fhyy/MF2063-ESS-NW-CAR/pcb/README.md

# PCB and schematics for the powering and communication 
In the "Power schematics" is the simulation file for the boost converter. The simulation program is MPLAB from Microchip and is used because the an IC from Microchip. In the folder pcb is the Eagle files for the power unit and the Arduino boards.
