fhyy/MF2063-ESS-NW-CAR/platform/README.md

## 3D models for Platform 
The platform for the car was simulated in Autodesk Fusion 360 and the schematics was exported to print out  the pieces on the laser cutter and 3D printer.
