fhyy/MF2063-ESS-NW-CAR/pcb/Power-Schematics/README.md

# Power schematics
In this folder is the file boost_converter_ess and is a MPLAB file to simulate the boost converter simulation.
