fhyy/MF2063-ESS-NW-CAR/pcb/pcb/README.md

# PCBs

# Board for Arduino IR esc
This is the file for the Arduino board to connect the the Speed sensor and ESC to steer them from Arduino 

# Board for Arduino ultras servo 
This is the file for the Arduino board to connect Ultrasound and steering servo.

# Ess car 
Is the file for the power unit and includes the boost converter 

# Ess car with out DC-DC
This the design for the power unit with out the boost converter.
