fhyy/MF2063-ESS-NW-CAR/ess-car-assignments/wishlist1/ESS-CAR-Design review wish_1.docx

# Design review wish-list #1

This is the first time you will meet the expert panel. At this stage you should have understood the task at hand. You should also have a project plan and stated the specific requirements for your task. This runs in parallel with the project management course EH2760.

Prepare a short presentation (~5 min) of your project. To get as good feedback as possible from the expert panel, prepare the wish-list below. Make sure that you think this through so you get as much as possible from this session. Focus on the “big issues”.

Make sure that you upload this to Canvas before the deadline (see kick off presentation).

## <Project title>

(Add information if the project task diverges from the initial project description)

KTH ESS-Car Embedded Services for a Self-Adaptive Car

## Wish-list

(State what you would like to discuss below. It can be high and low. Everything from real time control problems to manufacturing questions).

1. We plan to use a ultrasonic sensor to detect entities that in front of the car and a camera based on raspberry pi to capture visions. We want to discuss the combination of these sensors.
2. We have defined some errors that can be injected to the car and their related detection methods. We want to discuss if this is in the right path.
3. After some background study about anomaly detection, I think maybe some techniques corresponding to intelligent data processing can be introduced to detect fault. We wonder what sensitive fault features are in this prototype and what kind of data can be used in data processing and analysis.
4. The online datasets about labeled shapes are hard to find. We only found two datasets with low pixel numbers, which will have low performance on practical test. We’d like to know that whether there is a labeled shape dataset with higher pixel numbers.

MF2063 Embedded systems design project
