fhyy/MF2063-ESS-NW-CAR/Project_Management/Final_Report_Management/ESS-CARNW_2018_finalreport_1.pdf

KTH Management of Projects

EH2760, HT 2018

FINAL REPORT

# ESS-NW/ESS-CAR

Jonas Ekman

Yini Gao

Jacob Kimblad

Leon Fernandez

Fredrik Hyyrynen

Yifan Ruan

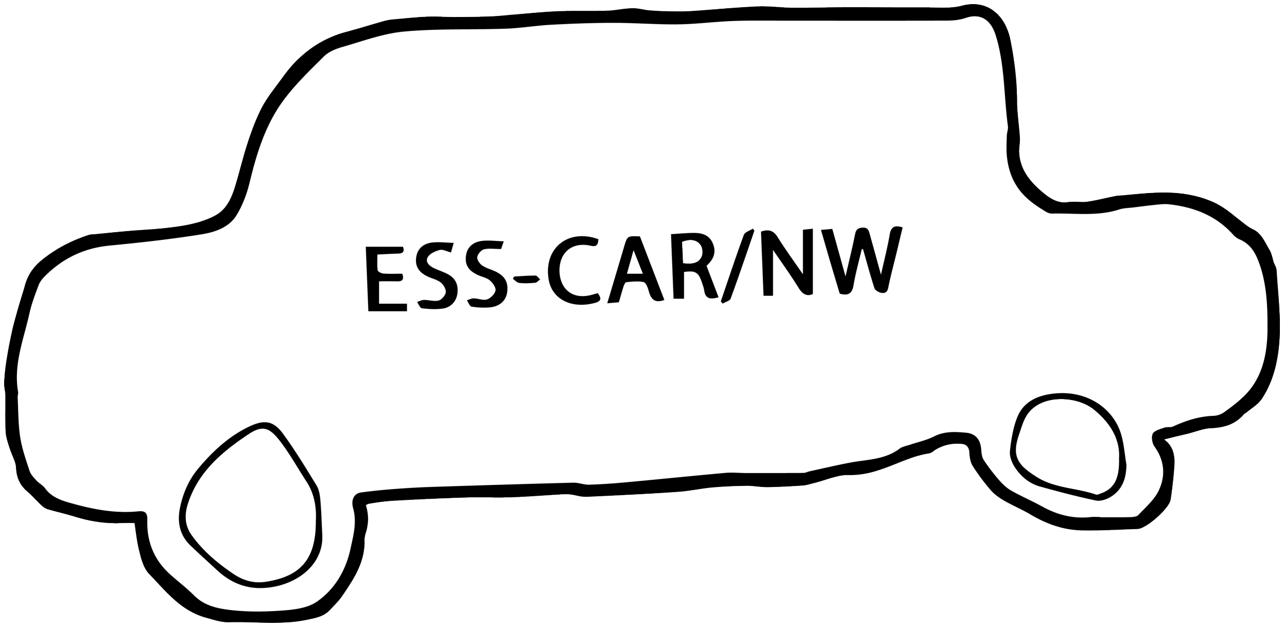
[picture p43: figure]

December 14, 2018

EH2760 Management of Projects ESS-NW/ESS-CAR
Leon Fernandez, leonfe@kth.se

Final Report
Version 1
1(8)

## 1 General Summary

A prototype for an autonomous car has been built. As requested, the car is able to do some basic self-monitoring and uses ethernet with a network controller for on-board communication. Unfortunately, it is not able to consistently track a flag, which was another requirement.
Due to integration issues, a lot more time than planned had to be spent during the last weeks of the project. The budget was exceeded by roughly 74%.
The integration issues consisted mostly of problems with the interprocess communication between different software tasks. During integration, it was also found that ordering PCBs via KTH was not possible and that the PCB machines available to the group were broken. The interprocess communication and the PCB issues were the main causes of delay in the project.

## 2 Follow-up of objectives

2.1 Goals

1. The computer vision system of the car does not have the required performance to properly follow a green circle held in front of the car.
2. The hardware has been extended to include one unique processor for each sensor or actuator node and the car has all the functionality it needs to keep a distance of 30 cm to an object in front.
3. The car has been made failsafe to the extent that it can detect if any of the major nodes are missing. Most importantly, the node that controls the motor can by itself stop the car within the required time, even if it gets isolated from the other nodes. No battery level reading has been implemented.
4. The software running on the controller node checks the availability of all subsystem and does not start if any of them are missing.
5. The physical layer has been set in a topology that allows the SDN-system to route packets to and from all nodes.
6. The SDN system consists of a SDN-controller that runs on a Raspberry Pi and Zodiac FX OpenFlow switches.
7. There is only one route between any two given nodes that are connected as hosts to the SDN system. As long as the SDN system is activated, packets are always take this route.
8. The SDN controller does not reassign network resources during runtime.

2.2 Action Plan

Goals 1, 3 and 8 cannot be considered completed. No action will be taken for goal 3 since the current situation was deemed acceptable by the stakeholders. The cause of failure for goal 1 and 8 have been identified and the shareholders have been notified. The action taken for these failures is to hand over a well-documented repository to the stakeholders so that they can have another group of students solve these issues in a future course round.

EH2760 Management of Projects ESS-NW/ESS-CAR
Leon Fernandez, leonfe@kth.se

Final Report
Version 1
2(8)

## 3 Lessons learned and suggestions for improvement

The experience with the project has, in general, been good. Most members felt that they got to work with relevant topics and try out new ideas. Furthermore, all members got to try out professional engineering tools and methods that will be useful in the future. Some examples include cmake, Doxygen, Slack, Fusion 360, Eagle and PyChar.
However, the group had quite a few experiences with inefficient meetings and throughout most of the project there was a consensus that more people were required. Although, an effort was made to implement a Scrum system using the Trello platform as well as a physical whiteboard, it did not work out in the end. Also, the integration of all the software subsystems got delayed, partly due to difficulties with both making and ordering a PCB.
Despite the difficulties with ordering a PCB and the inefficient meetings, most of the communication with suppliers and stakeholders worked smoothly. Lastly, even though not all goals were fulfilled, the project members felt that they made the right choices in prioritizing what would be the final deliverables.

3.1 Lessons learned

- To improve the time utilization, it would have been good to have a project manager who does little or no development.
- To improve the Scrum system, only one board should have been employed instead of using both a whiteboard and a digital Scrum board.
- To improve the meeting efficiency, a more formal meeting structure should have been employed.
- More flexibility when it comes to restating the goals. For instance, the goals should have been restated when it at one point was discovered that previous work would have to be redone.
- Write more detailed technical requirements that can help facilitate the task breakdown.

## 4 Summary of time and resource plans

The final versions of the time and resource plans can be seen in Figure 3 and 2. All tasks up until mid-november were dealt with in time. After that, a lot of tasks hade to be postponed and the order of some of the tasks had to be changed as well. This was mostly due to integration problems with the different software subsystems that had been developed. Something that was missing in the time plan that could have mitigated this issue was to set aside a few days for implementing the interprocess communication between software tasks, as this was the main reason for the integration problems. Another reason for the delay was issues with ordering PCBs and broken PCB prototype machines. Unfortunately there was nothing in the risk analysis that reflected this specific issue, which could probably have been mitigated with some simple proactive measures like hand soldering prototype cards early on in the project.
Note: Milestones that were never met are denoted by a red semicircle in Figure 2.

## 5 Final comments

We in the group felt that we really made an effort to conduct the project in a professional and structured way. However, we also felt that with a project manager who also was a developer, this was very difficult. The project would really have benefitted from having one person with an overview of the status of all subsystems, so that resources can be delegated accordingly. Despite the shortcomings

EH2760 Management of Projects ESS-NW/ESS-CAR
Leon Fernandez, leonfe@kth.se

Final Report
Version 1
3(8)

of the project, we still feel that we have gained some valuable knowledge and experience, both in pure technical skills and within project management.

EH2760 Management of Projects ESS-NW/ESS-CAR
Leon Fernandez, leonfe@kth.se

Final Report
Version 1
4(8)

## A EVM

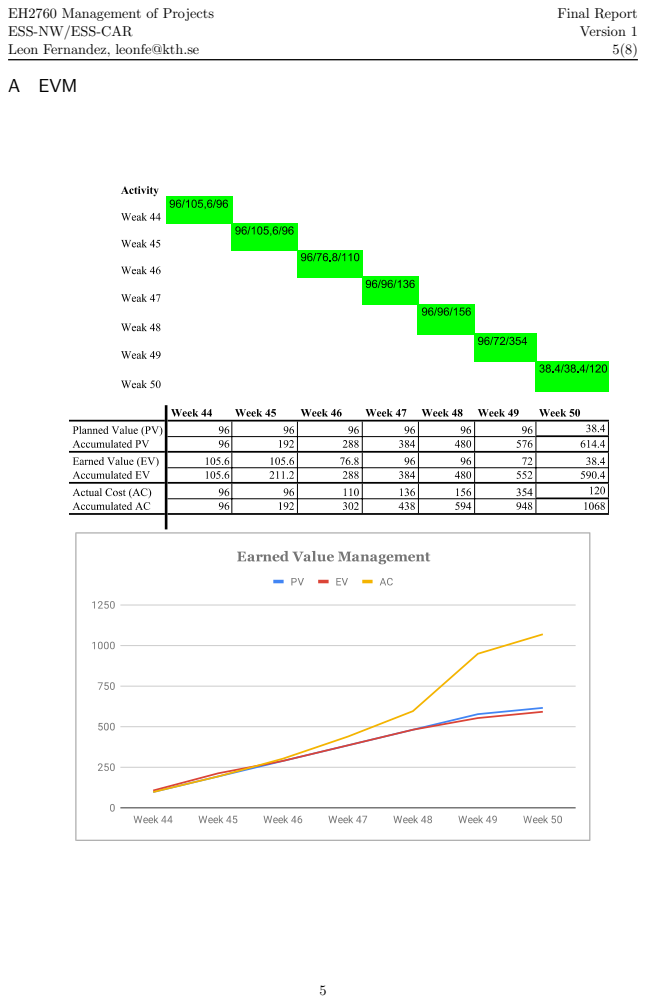
[picture p44: page 6]
Final Report Version 1 5(8)

EH2760 Management of Projects
ESS-NW/ESS-CAR
Leon Fernandez, leonfe@kth.se

Figure 1: Earned Value Management analysis.

EH2760 Management of Projects ESS-NW/ESS-CAR
Leon Fernandez, leonfe@kth.se

Final Report
Version 1
6(8)

## B Time Plan

## C Resource Plan

EH2760 Management of Projects ESS-NW/ESS-CAR
Leon Fernandez, leonfe@kth.se

Final Report
Version 1
7(8)

Project name: ESS-CAR/NW Milestone chart

Group number:

Oct Nov Dec

Day 29 30 31 1 2 3 4 5 6 8 9 10 11 12 13 14 15 16 17 18 19 20 21 22 23 24 25 26 27 28 29 30 1 2 3 4 5 6 7 8 9 10 11 12 13 14 15 16

Milestone/ tollgate O/ 30,5 15,16 29 17,18 3 13,25 19,21 27 1,7,9,11 31 2,4,6,8,10,12,14,26,28 20,22 23 24 32

Updated:

10/10/2018

11/9/2018 ● ● ● ▼ ● ●▼ ◯ ◯ ◯ ◯ ▽ ◯ ◯ ◯ ◯◯ ◯ ▽ ▽ ▽ ▽ ▽ ▽ ▽ ▽ ▽ ◯ ▽ ◯ ▽ ▽

11/15/2018 ● ◯ ◯ ● ▼ ● ◯ ● ● ◯ ◯ ▽ ▽ ▽ ▽ ▽ ▽ ▽ ▽ ▽ ◯ ▽ ◯ ▽ ▽

11/29/2018 ◯▽ ▽ ▽ ▽ ▽ ▽ ▽ ▽ ▽ ▽ ◯◯ ◯ ◯◯ ◯ ▽ ▽
12/13/2018 ● ▼ ▼ ▼ ▼ ▼ ▼ ▼ ▼ ▼ ▼ ● ◓ ● ● ● ●▼ ▼

Project manager Milestone O / Tollgate

1 SDN Network done 5 Vision object detection done 9 Boot up sequence done 13 Power supply for car done 17 Status report 2 done 21 Status report 3 submission

2 SDN Network approved 6 Vision object detection approved 10 Boot up sequence approved 14 Power supply approved 18 Status report 2 submission 22 Status report 4 submission

3 Control software for car done 7 Collision detection done 11 Fault handling done 15 Status report 1 done 19 Status report 3 done 23 Final report done

4 Control software of car approved 8 Collision detection approved 12 Fault handling approved 16 Status report 1 submission 20 Status report 4 done 24 Final report submission (Embedded Design Project)

25 Assemble car done 27 Autonomous system done 29 Working SDN prototype 31 Working autonomous prototype

26 Assemble car approved 28 Autonomous system approved 30 Working sensor and actuators prototype 32 Final report submission (Embedded Design Project) Figure 2: Time plan for the project.

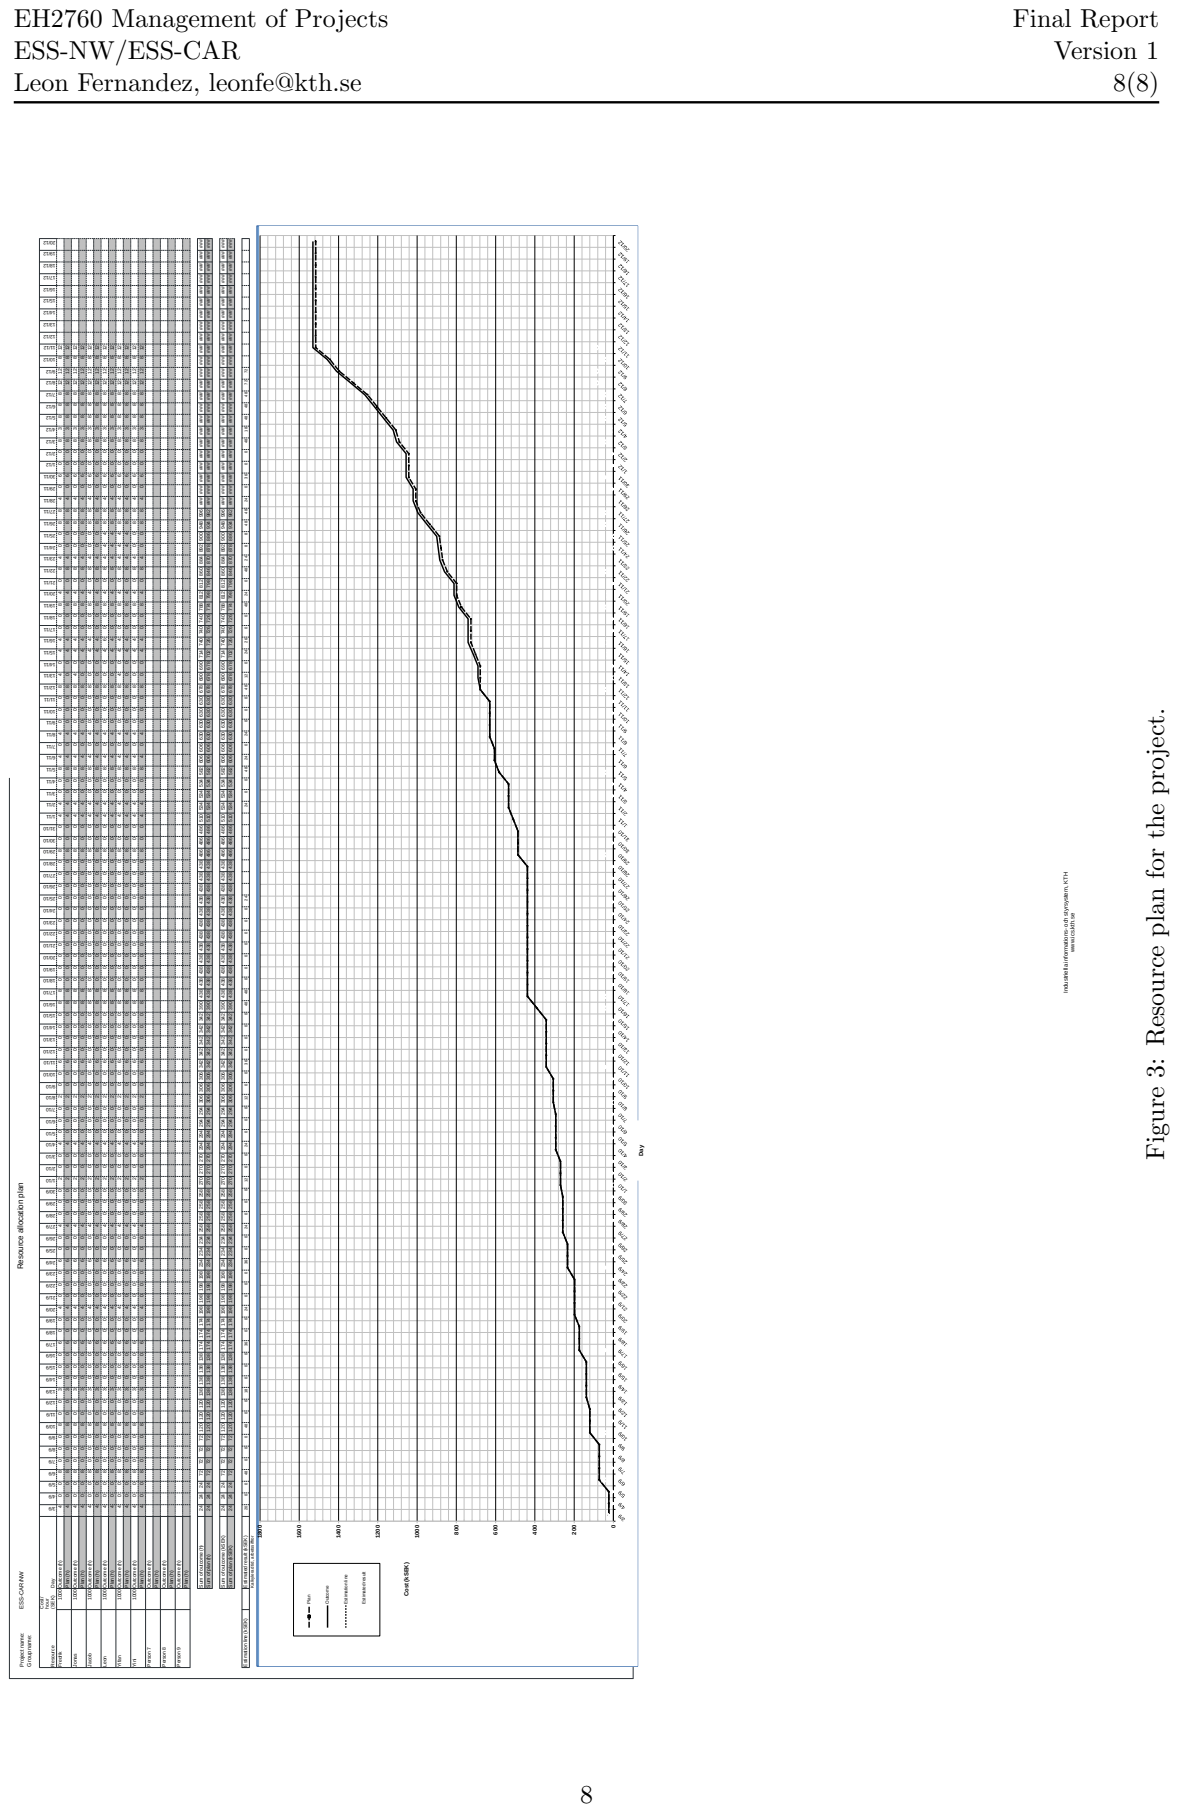
[picture p45: page 9]
Final Report Version 1 8(8); Group name:; Resource Day 9/ 3; Fredrik 1000 Outcome (h) 4 0 0 8 0 0 0 8 0 0 3 0 0 0 6 0 0 4 0 0 0 6 0 0 4 0 0 0 2 0 0 4 0 0 0 2 0 0 6 0 0 0 0 8 8 0 0 0 0 0 0 0 0 0 0 0 8 0 0 4 4 0 0 8 4 0 4 0 0 0 8 4 0 4 4 0 0 8 4 0 8 4 0 0 8 8 4 0 6 0 0 8 3 8 8 8 12 12 8 12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

EH2760 Management of Projects
ESS-NW/ESS-CAR
Leon Fernandez, leonfe@kth.se

Sum of outcome (h) 24 24 24 72 72 72 72 120 120 120 138 138 138 138 174 174 174 198 198 198 198 234 234 234 258 258 258 258 270 270 270 294 294 294 294 306 306 306 342 342 342 342 342 390 438 438 438 438 438 438 438 438 438 438 438 438 486 486 486 510 534 534 534 582 606 606 630 630 630 630 678 690 690 714 740 740 740 788 812 812 860 884 892 900 948 996 ### ### ### ### ### ### ### ### ### ### ### ### ### ### ### ### ### ### ### ### ### ### ###

Sum of plan (h) 24 24 24 72 72 72 72 120 120 120 138 138 138 138 174 174 174 198 198 198 198 234 234 234 258 258 258 258 270 270 270 294 294 294 294 306 306 306 342 342 342 342 342 390 438 438 438 438 438 438 438 438 438 438 438 438 486 486 486 510 534 534 534 582 606 606 630 630 630 630 678 678 678 702 726 726 726 774 798 798 846 870 878 886 934 982 ### ### ### ### ### ### ### ### ### ### ### ### ### ### ### ### ### ### ### ### ### ### ###

Sum of outcome (kSEK) 24 24 24 72 72 72 72 120 120 120 138 138 138 138 174 174 174 198 198 198 198 234 234 234 258 258 258 258 270 270 270 294 294 294 294 306 306 306 342 342 342 342 342 390 438 438 438 438 438 438 438 438 438 438 438 438 486 486 486 510 534 534 534 582 606 606 630 630 630 630 678 690 690 714 740 740 740 788 812 812 860 884 892 900 948 996 ### ### ### ### ### ### ### ### ### ### ### ### ### ### ### ### ### ### ### ### ### ### ###

Sum of plan (kSEK) 24 24 24 72 72 72 72 120 120 120 138 138 138 138 174 174 174 198 198 198 198 234 234 234 258 258 258 258 270 270 270 294 294 294 294 306 306 306 342 342 342 342 342 390 438 438 438 438 438 438 438 438 438 438 438 438 486 486 486 510 534 534 534 582 606 606 630 630 630 630 678 678 678 702 726 726 726 774 798 798 846 870 878 886 934 982 ### ### ### ### ### ### ### ### ### ### ### ### ### ### ### ### ### ### ### ### ### ### ###

Estimation line (kSEK) Estimated result (kSEK) 20 0 0 48 0 0 0 48 0 0 18 0 0 0 36 0 0 24 0 0 0 36 0 0 24 0 0 0 12 0 0 24 0 0 0 12 0 0 36 0 0 0 0 48 48 0 0 0 0 0 0 0 24 24 0 0 48 24 0 24 0 0 0 48 12 0 24 26 0 0 48 24 0 48 24 8 8 48 48 24 0 36 0 0 48 18 48 48 48 72 72

Figure 3: Resource plan for the project.

Industriella informations- och styrsystem, KTH

www.ics.kth.se

Project name: ESS-CAR/NW Resource allocation plan

Kalkylerad tid, arbetssiffror
