fhyy/MF2063-ESS-NW-CAR/Project_Management/Final_Report_Management/figures/timeplan.pdf

Project name: ESS-CAR/NW | Milestone chart

# Group number:

Oct | Nov | Dec
Day Milestone/ tollgate O/ Updated: | 29 | 30 | 31 | 1 | 2 | 3 | 4 | 5 | 6 | 8 30,5 | 9 15,16 | 10 | 11 | 12 | 13 29 | 14 | 15 | 16 17,18 | 17 | 18 | 19 | 20 | 21 3 | 22 13,25 | 23 19,21 | 24 | 25 | 26 27 | 27 1,7,9,11 | 28 31 | 29 2,4,6,8,10,12,14,26,28 | 30 20,22 | 1 | 2 | 3 | 4 | 5 | 6 | 7 | 8 | 9 | 10 23 | 11 24 | 12 | 13 | 14 32 | 15 | 16
10/10/2018 11/9/2018 11/15/2018 11/29/2018 12/13/2018 | | | | | | | | | | ● ● | ● ▼ | | | | ● | | | ●▼ | | | | | ◯ ● | ◯ ◯ ◯ ◯ | ◯ ▽ ● ▼ | | | ◯ ● | ◯ ◯ ◯◯ ◯ ● ● ◯ | ◯ ◯ | ▽ ▽ ▽ ▽ ▽ ▽ ▽ ▽ ▽ ▽ ▽ ▽ ▽ ▽ ▽ ▽ ▽ ▽ | ◯ ▽ ◯ ▽ ◯▽ ● ▼ | | | ▽ ▽ ▽ ▽ ▽ ▽ ▽ ▽ ▽ ▼ ▼ ▼ ▼ ▼ ▼ ▼ ▼ ▼ | ◯◯ ● | ◯ ◓ | | ◯◯ | | | ◯ ◯ ◯ ● ● | ▽ ▽ ▽ ● ●▼ | | | ▽ ▽ ▽ ▼
Project manager | Milestone O / Tollgate

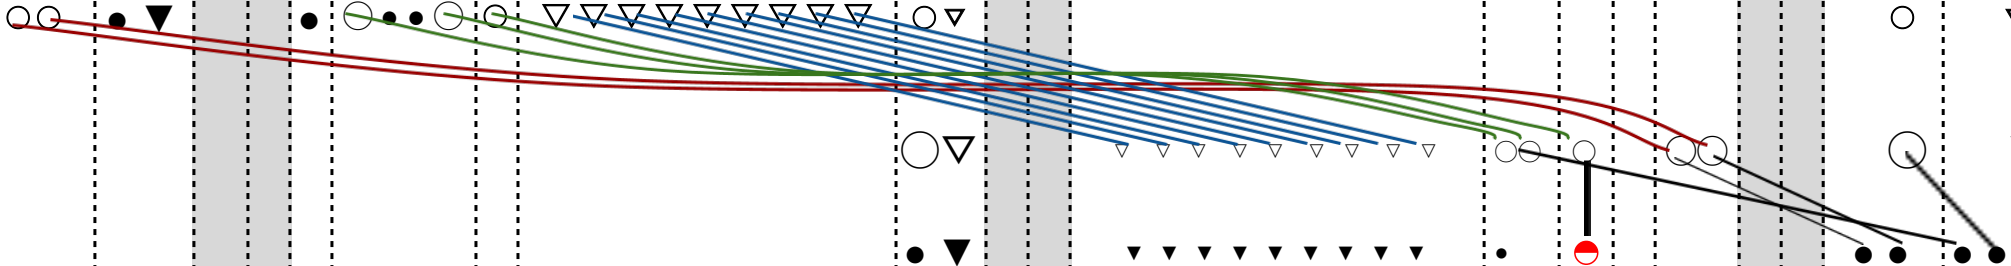
[picture p52: figure]
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
