fhyy/MF2063-ESS-NW-CAR/rpi-sdn-controller/Ryu-code/README.md

# Ryu controller

To start the controller has the Ryu framework be install from this GitHub page "https://github.com/osrg/ryu" and then run the shell script as shown 

```
./startsdn.sh
```
This code will start the SDN code and the webpage to monitor the network. 

## startsdn.sh
Is the shell script to start SDN and monitoring webpage.

## sdn_ryu_controller_monitor.py
This is the code that Ryu run on and is the file to write in to add new feathers to the SDN. 

## Gui_topology 
Is the folder contains the files to run the webpage
