fhyy/MF2063-ESS-NW-CAR/ess-nw-assignments/wishlist_1/wishlist_1_essnw_MF2063.tex

% !TEX TS-program = pdflatex
% !TEX encoding = UTF-8 Unicode

% This is a simple template for a LaTeX document using the "article" class.
% See "book", "report", "letter" for other types of document.

\documentclass[11pt]{article} % use larger type; default would be 10pt

\usepackage[utf8]{inputenc} % set input encoding (not needed with XeLaTeX)

\usepackage{enumerate}

%%% Examples of Article customizations
% These packages are optional, depending whether you want the features they provide.
% See the LaTeX Companion or other references for full information.

%%% PAGE DIMENSIONS
\usepackage{geometry} % to change the page dimensions
\geometry{a4paper} % or letterpaper (US) or a5paper or....
% \geometry{margins=2in} % for example, change the margins to 2 inches all round
% \geometry{landscape} % set up the page for landscape
%   read geometry.pdf for detailed page layout information

\usepackage{graphicx} % support the \includegraphics command and options

% \usepackage[parfill]{parskip} % Activate to begin paragraphs with an empty line rather than an indent

%%% PACKAGES
\usepackage{booktabs} % for much better looking tables
\usepackage{array} % for better arrays (eg matrices) in maths
\usepackage{paralist} % very flexible & customisable lists (eg. enumerate/itemize, etc.)
\usepackage{verbatim} % adds environment for commenting out blocks of text & for better verbatim
\usepackage{subfig} % make it possible to include more than one captioned figure/table in a single float
% These packages are all incorporated in the memoir class to one degree or another...

%%% HEADERS & FOOTERS
\usepackage{fancyhdr} % This should be set AFTER setting up the page geometry
\pagestyle{fancy} % options: empty , plain , fancy
\renewcommand{\headrulewidth}{0pt} % customise the layout...
\lhead{}\chead{}\rhead{}
\lfoot{}\cfoot{\thepage}\rfoot{}

%%% SECTION TITLE APPEARANCE
\usepackage{sectsty}
\allsectionsfont{\sffamily\mdseries\upshape} % (See the fntguide.pdf for font help)
% (This matches ConTeXt defaults)

%%% ToC (table of contents) APPEARANCE
\usepackage[nottoc,notlof,notlot]{tocbibind} % Put the bibliography in the ToC
\usepackage[titles,subfigure]{tocloft} % Alter the style of the Table of Contents
\renewcommand{\cftsecfont}{\rmfamily\mdseries\upshape}
\renewcommand{\cftsecpagefont}{\rmfamily\mdseries\upshape} % No bold!

%%% END Article customizations

%%% The "real" document content comes below...

\title{MF2063: Design Review Wish-List \#1}
\author{Leon Fernandez (leonfe@kth.se) \\
        Jacob Kimblad (jacobki@kth.se) \\
        Fredrik Hyyrynen (fhyy@kth.se) \\
        Jonas Ekman (jonekm@kth.se)}
\date{} % Activate to display a given date or no date (if empty),
         % otherwise the current date is printed 

\begin{document}
\maketitle

\section*{Project: ESS-NW}
The ESS-NW project consists of making a small semi-autonomous car. The car system will be made up of several different computing nodes (roughly 12) such as
sensors, actuators and controllers. What the project aims to investigate is how a Software Defined Network (SDN) can be used to ensure
reliability and predictability of the system.

\subsection*{Questions}
\begin{enumerate}
\item What are the key performance metrics when investigating network traffic and how are these measured?
\item Predictability is an important aspect of the system. We are thinking of using a static schedule for this, but how do we implement it on a SDN network?
\item How do you run a program upon booting the Raspberry Pi or the BeagleBone, for example a computer vision application?
\end{enumerate}

\end{document}
