fhyy/MF2063-ESS-NW-CAR/Project_Management/Final_Report_Embedded/figures/overview.pdf

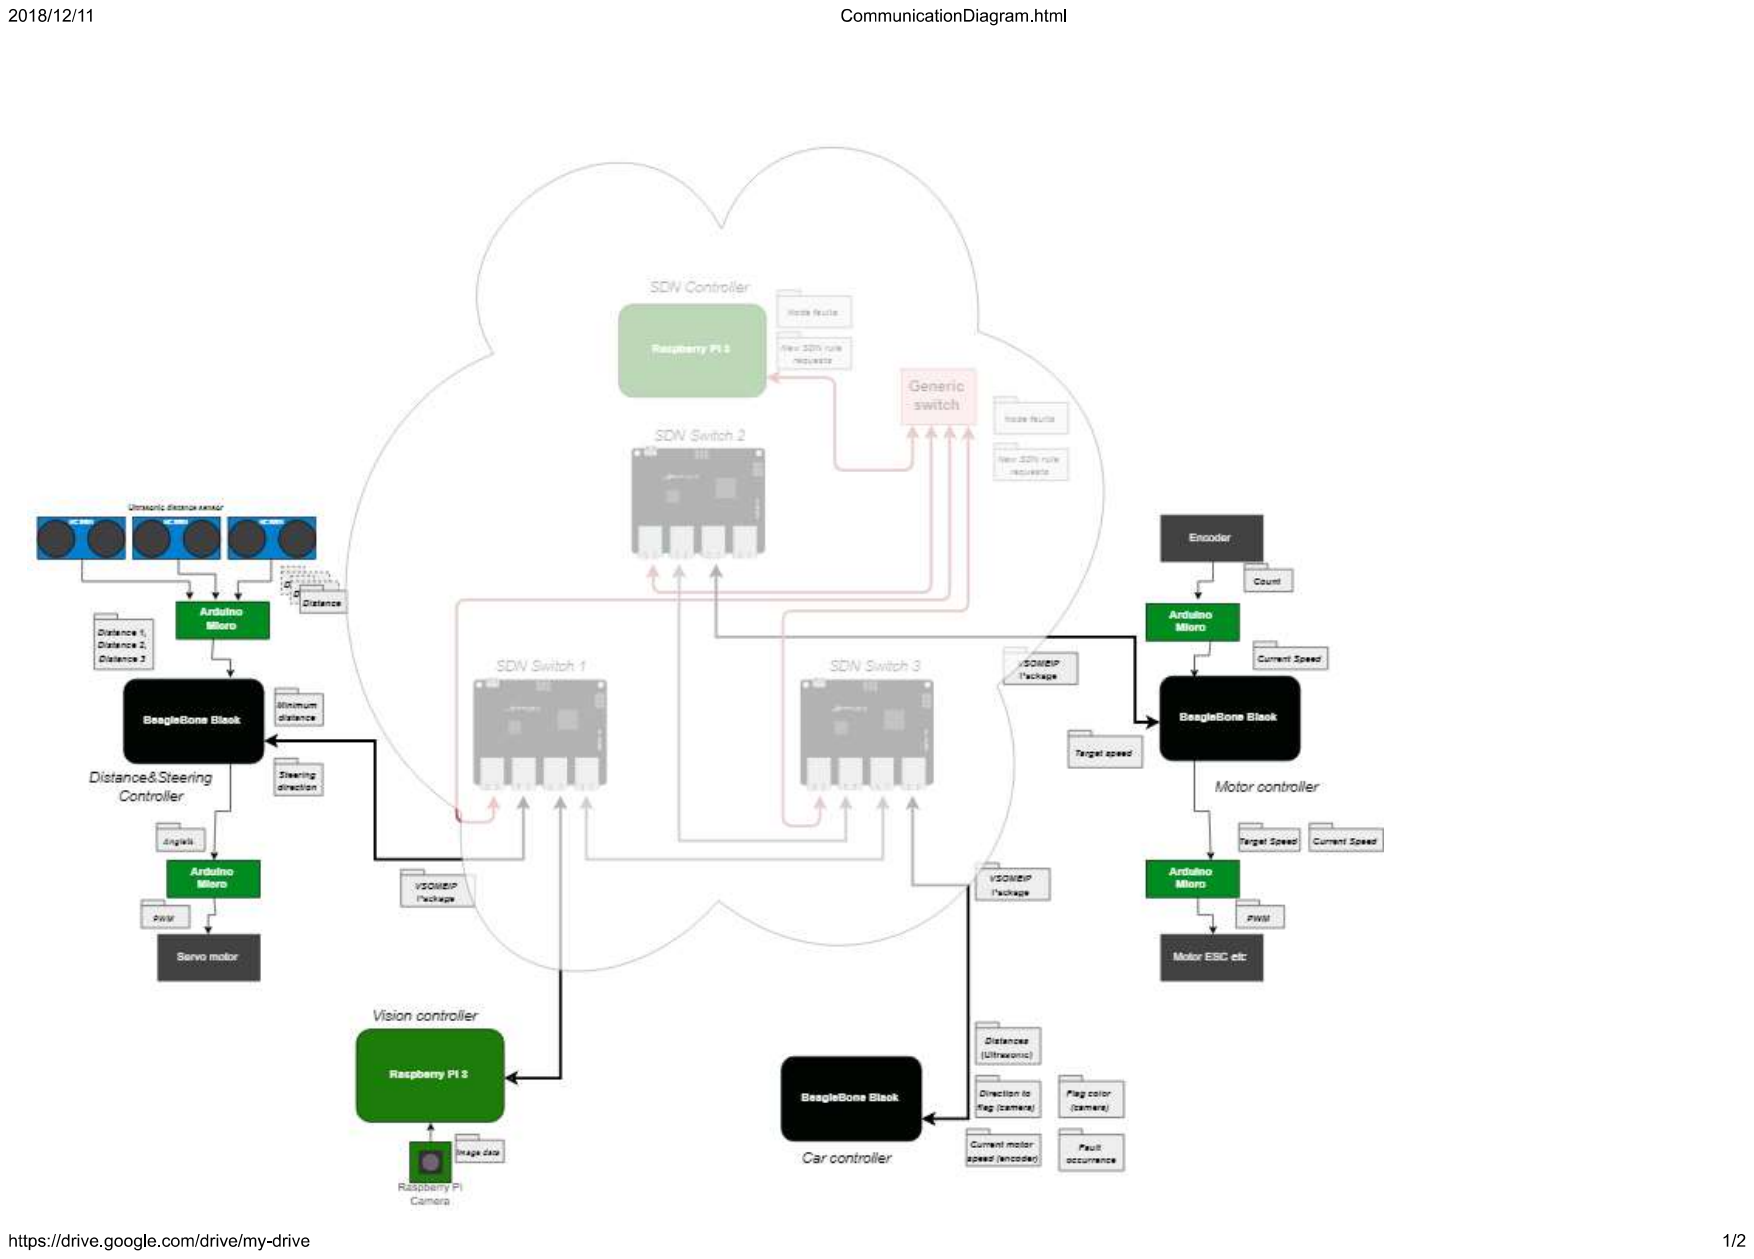
[picture p53: page 1]
