fhyy/MF2063-ESS-NW-CAR/presentation/pp/pp.pdf

# ESS-NW/CAR

Leon Fernandez, Jonas Ekman, Fredrik Hyyrynen, Jacob Kimblad,

# Yini Gao and Yifan Ruan

MF2063

# December 10, 2018

Leon Fernandez, Jonas Ekman, Fredrik Hyyrynen, Jacob Kimblad, Yini Gao and Yifan Ruan (KTH) ESS-NW/CAR | December 10, 2018 | 1 / 19

# Overview

1 | Introduction and background Autonomous vehicles Communication technologies Software-Defined Networking
2 | Our project Goals System architecture Implemented services
3 | Summary
Leon Fernandez, Jonas Ekman, Fredrik Hyyrynen, Jacob Kimblad, Yini Gao and Yifan Ruan (KTH) ESS-NW/CAR | December 10, 2018 | 2 / 19

# Introduction and background

Leon Fernandez, Jonas Ekman, Fredrik Hyyrynen, Jacob Kimblad, Yini Gao and Yifan Ruan (KTH) ESS-NW/CAR | December 10, 2018 | 3 / 19

# Autonomous vehicles

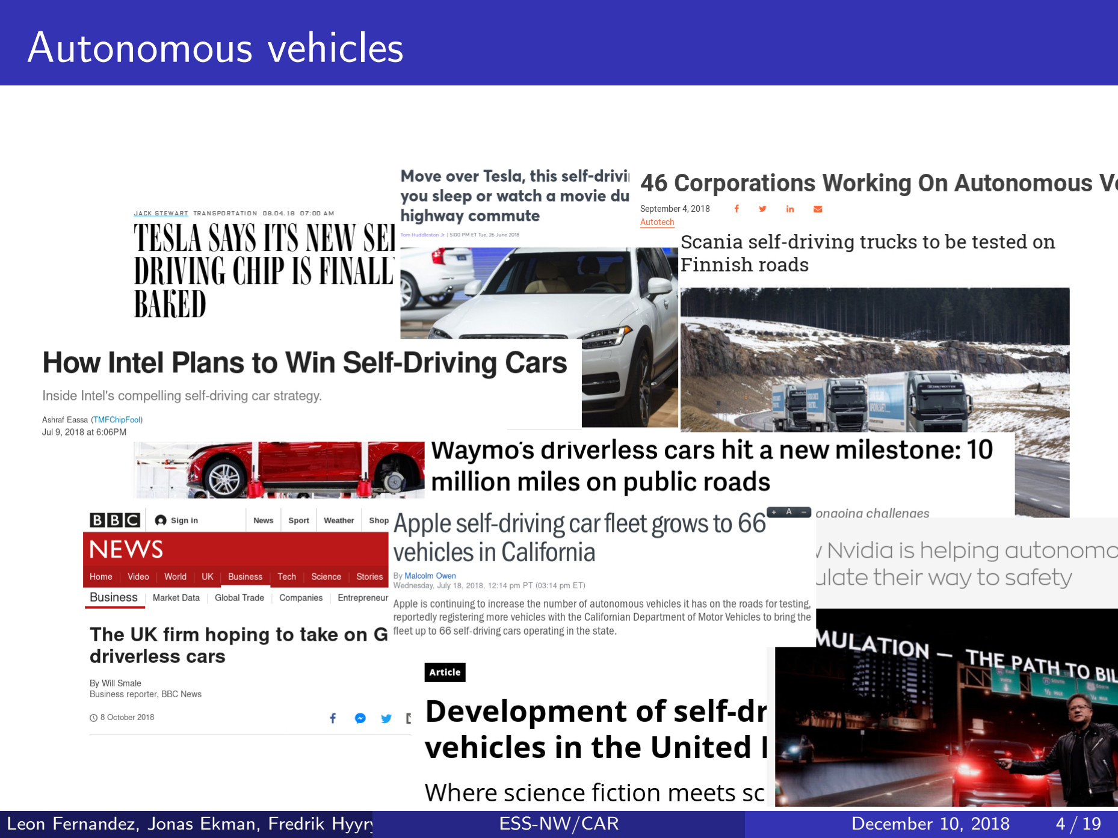
[picture p54: page 4]

Leon Fernandez, Jonas Ekman, Fredrik Hyyrynen, Jacob Kimblad, Yini Gao and Yifan Ruan (KTH) ESS-NW/CAR | December 10, 2018 | 4 / 19

# Autonomous vehicles

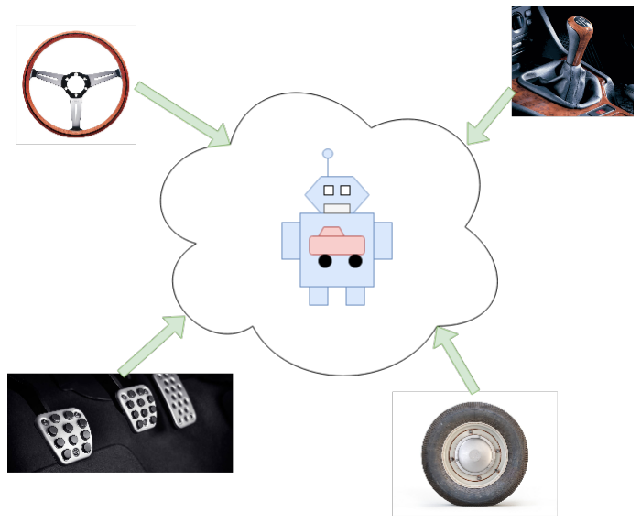
[picture p55: figure]

Leon Fernandez, Jonas Ekman, Fredrik Hyyrynen, Jacob Kimblad, Yini Gao and Yifan Ruan (KTH) ESS-NW/CAR | December 10, 2018 | 5 / 19

# Autonomous vehicles

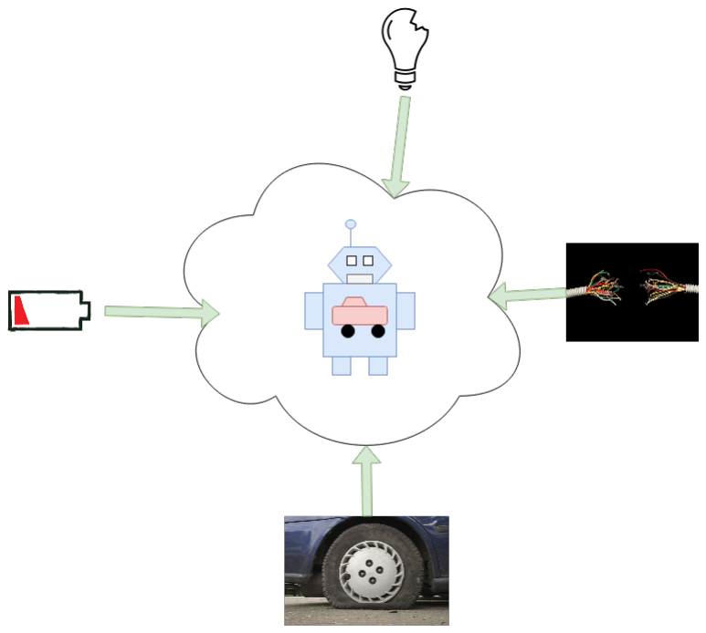
[picture p56: figure]

Leon Fernandez, Jonas Ekman, Fredrik Hyyrynen, Jacob Kimblad, Yini Gao and Yifan Ruan (KTH) ESS-NW/CAR | December 10, 2018 | 6 / 19

# Autonomous vehicles

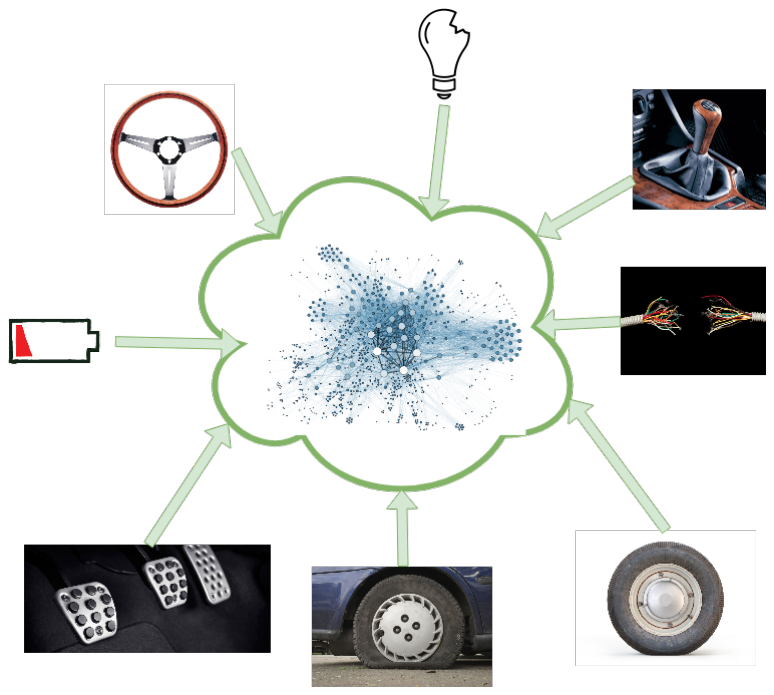
[picture p57: figure]

Leon Fernandez, Jonas Ekman, Fredrik Hyyrynen, Jacob Kimblad, Yini Gao and Yifan Ruan (KTH) ESS-NW/CAR | December 10, 2018 | 7 / 19

# The problem with existing communication technologies

# Existing communication technologies between internal computers in cars:

## CAN (1 Megabit/s) LIN (19.2 Kilobit/s) FlexRay (10 Megabit/s)

# Too slow for autonomous cars!

# Regular internet based technologies can be a solution for

communication in cars.
Wired ethernet speeds reach into the Gigabit/s range.


Leon Fernandez, Jonas Ekman, Fredrik Hyyrynen, Jacob Kimblad, Yini Gao and Yifan Ruan (KTH) ESS-NW/CAR | December 10, 2018 | 8 / 19

# The problem with existing communication technologies

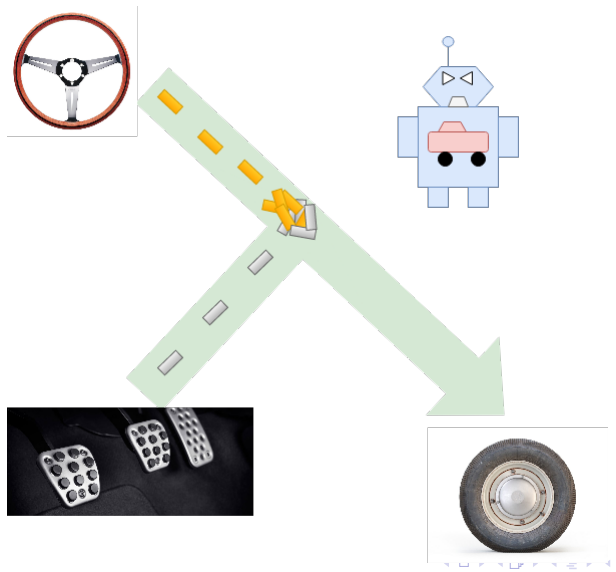
[picture p58: figure]

Leon Fernandez, Jonas Ekman, Fredrik Hyyrynen, Jacob Kimblad, Yini Gao and Yifan Ruan (KTH) ESS-NW/CAR | December 10, 2018 | 9 / 19

# Software-Defined Networking (SDN)

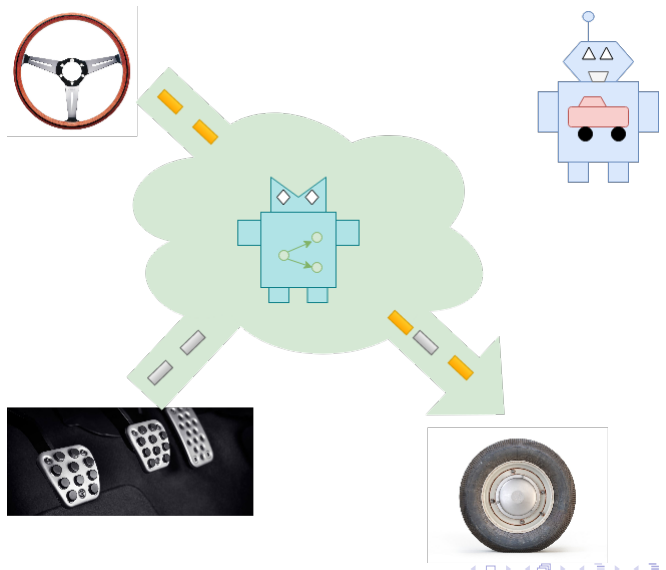
[picture p59: figure]

Leon Fernandez, Jonas Ekman, Fredrik Hyyrynen, Jacob Kimblad, Yini Gao and Yifan Ruan (KTH) ESS-NW/CAR | December 10, 2018 | 10 / 19

# Software-Defined Networking (SDN)

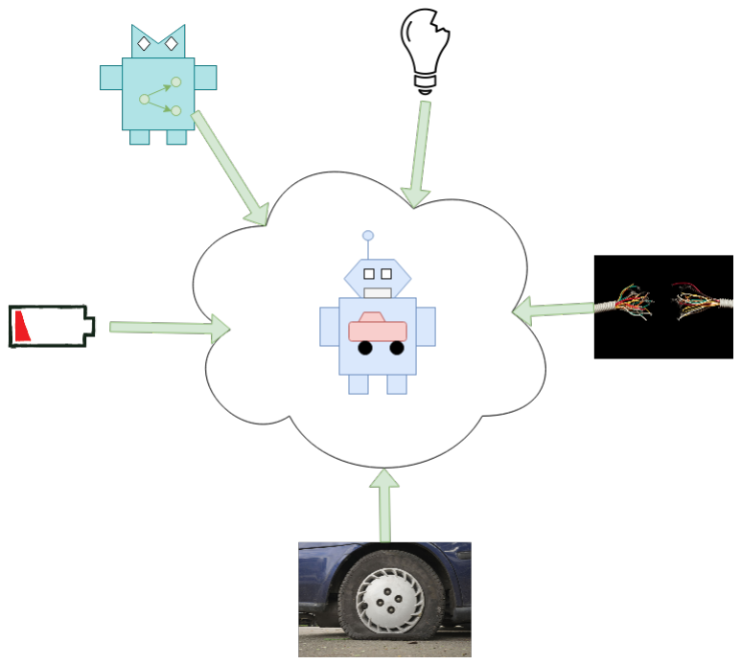
[picture p60: figure]

Leon Fernandez, Jonas Ekman, Fredrik Hyyrynen, Jacob Kimblad, Yini Gao and Yifan Ruan (KTH) ESS-NW/CAR | December 10, 2018 | 11 / 19

# Our project

Leon Fernandez, Jonas Ekman, Fredrik Hyyrynen, Jacob Kimblad, Yini Gao and Yifan Ruan (KTH) ESS-NW/CAR | December 10, 2018 | 12 / 19

# Goals of the project

# Produce a prototype of an SDN-based communication infrastructure

for automotive vehicles.

# Produce a prototype of intelligent system monitoring and adaptation

service for automotive vehicles.

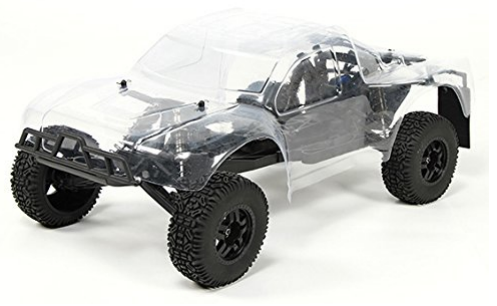
[picture p61: figure]

## Figure: RC-car model kit used for the prototype

Leon Fernandez, Jonas Ekman, Fredrik Hyyrynen, Jacob Kimblad, Yini Gao and Yifan Ruan (KTH) ESS-NW/CAR | December 10, 2018 | 13 / 19

# System architecture

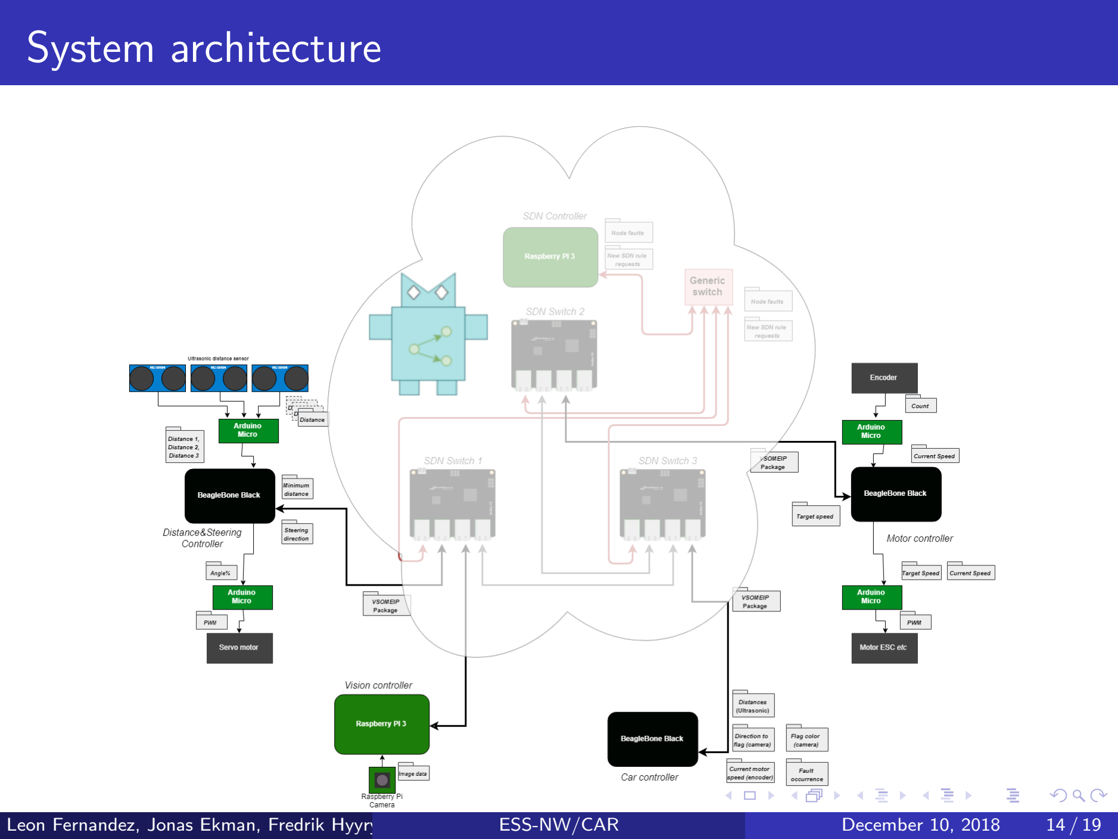
[picture p62: page 14]

Leon Fernandez, Jonas Ekman, Fredrik Hyyrynen, Jacob Kimblad, Yini Gao and Yifan Ruan (KTH) ESS-NW/CAR | December 10, 2018 | 14 / 19

# Implemented services

# Speedometer

# Cruise control

# Steering

# Object recognition

# Distance measurement

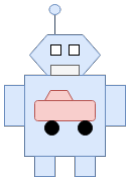
[picture p63: figure]

Leon Fernandez, Jonas Ekman, Fredrik Hyyrynen, Jacob Kimblad, Yini Gao and Yifan Ruan (KTH) ESS-NW/CAR | December 10, 2018 | 15 / 19

# Network surveillance

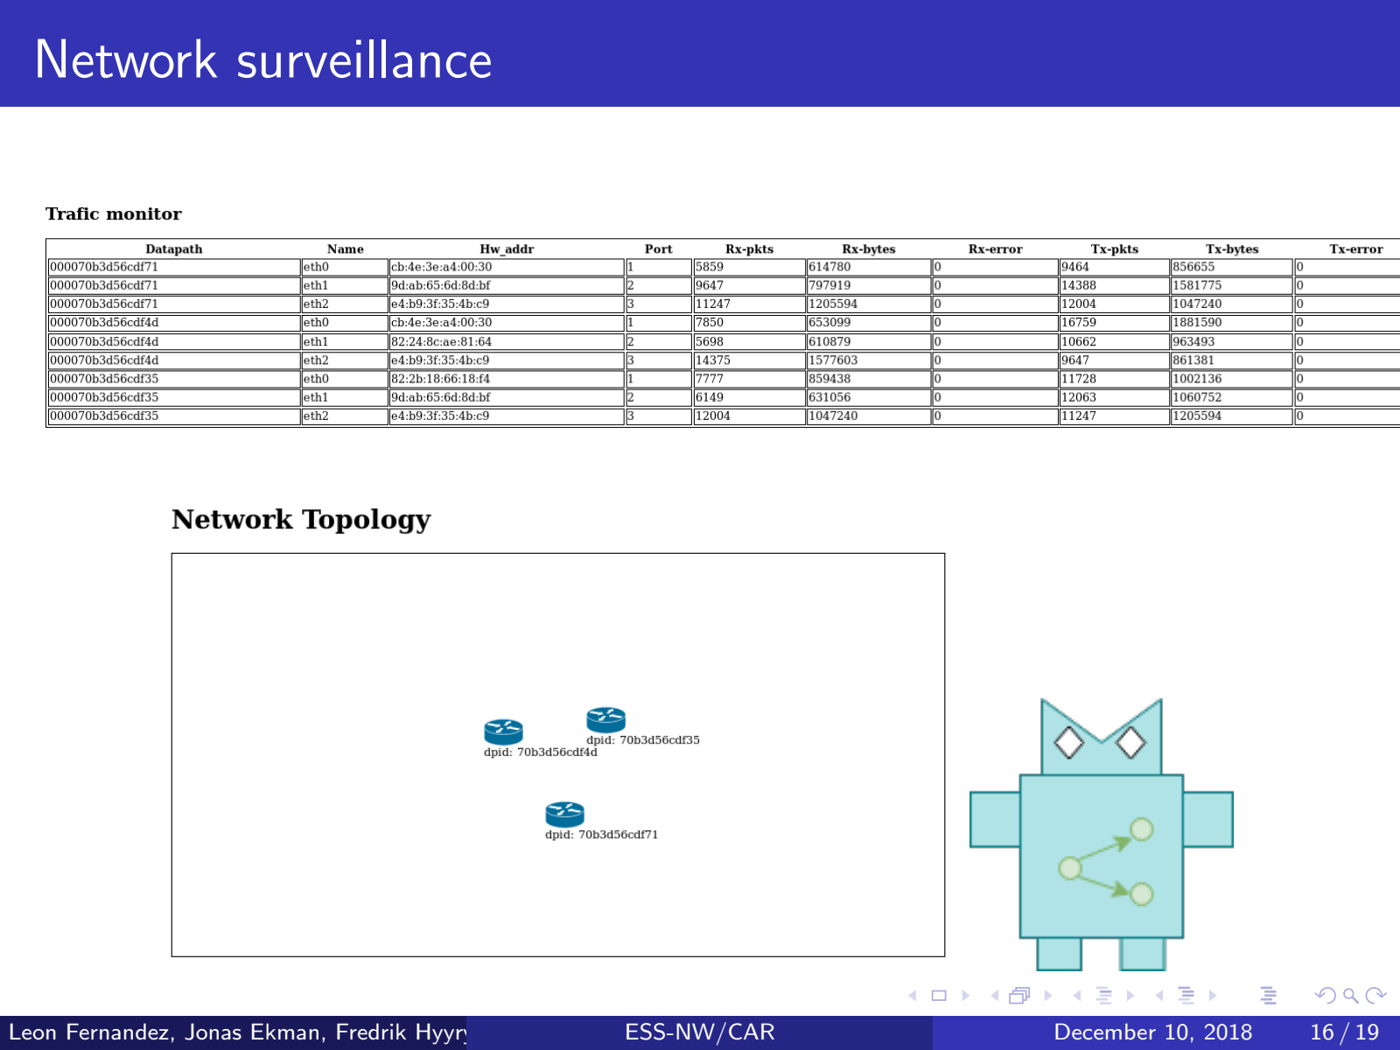
[picture p64: page 16]

Leon Fernandez, Jonas Ekman, Fredrik Hyyrynen, Jacob Kimblad, Yini Gao and Yifan Ruan (KTH) ESS-NW/CAR | December 10, 2018 | 16 / 19

# Summary

Leon Fernandez, Jonas Ekman, Fredrik Hyyrynen, Jacob Kimblad, Yini Gao and Yifan Ruan (KTH) ESS-NW/CAR | December 10, 2018 | 17 / 19

# Summary

# Ethernet is a promising candidate for increasing demand on bandwidth for communication in autonomous cars

# Ethernet is not without problems, many of which a SDN can help to

solve.

# SDN networks allow for safe communications on autonomous vehicles by being fast, adaptive and customisable

# Fault detection and failsafe behaviour is a must in autonomous

vehicles.

Leon Fernandez, Jonas Ekman, Fredrik Hyyrynen, Jacob Kimblad, Yini Gao and Yifan Ruan (KTH) ESS-NW/CAR | December 10, 2018 | 18 / 19

# Come check out our DEMO in the prototyping lab on floor 3!

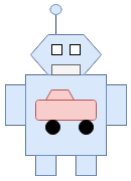
[picture p65: figure]
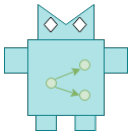
[picture p66: figure]

Leon Fernandez, Jonas Ekman, Fredrik Hyyrynen, Jacob Kimblad, Yini Gao and Yifan Ruan (KTH) ESS-NW/CAR | December 10, 2018 | 19 / 19
