fhyy/MF2063-ESS-NW-CAR/doc/html/ard-distance-spi_8ino__incl.png

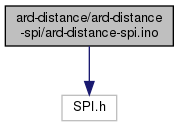
doc/html/ard-distance-spi_8ino__incl.png
