fhyy/MF2063-ESS-NW-CAR/doc/html/classCameraService__coll__graph.png

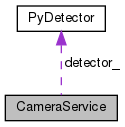
doc/html/classCameraService__coll__graph.png
