fhyy/MF2063-ESS-NW-CAR/doc/html/classCarCTRLClient__coll__graph.png

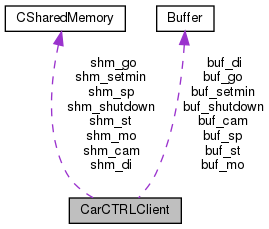
doc/html/classCarCTRLClient__coll__graph.png
