fhyy/MF2063-ESS-NW-CAR/doc/html/classDistSteerService__coll__graph.png

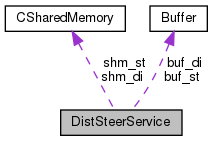
doc/html/classDistSteerService__coll__graph.png
