fhyy/MF2063-ESS-NW-CAR/doc/html/classESSPrototype__coll__graph.png

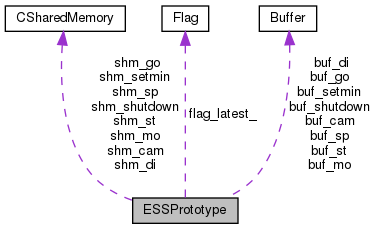
doc/html/classESSPrototype__coll__graph.png
