fhyy/MF2063-ESS-NW-CAR/doc/html/classMotorSpeedService__coll__graph.png

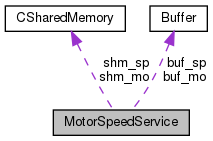
doc/html/classMotorSpeedService__coll__graph.png
