fhyy/MF2063-ESS-NW-CAR/doc/html/esc__programmer_8ino__incl.png

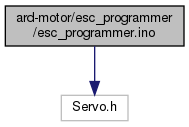
doc/html/esc__programmer_8ino__incl.png
