fhyy/MF2063-ESS-NW-CAR/doc/html/motor__control_8ino__incl.png

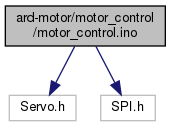
doc/html/motor__control_8ino__incl.png
