fhyy/MF2063-ESS-NW-CAR/presentation/poster/figures/network.png

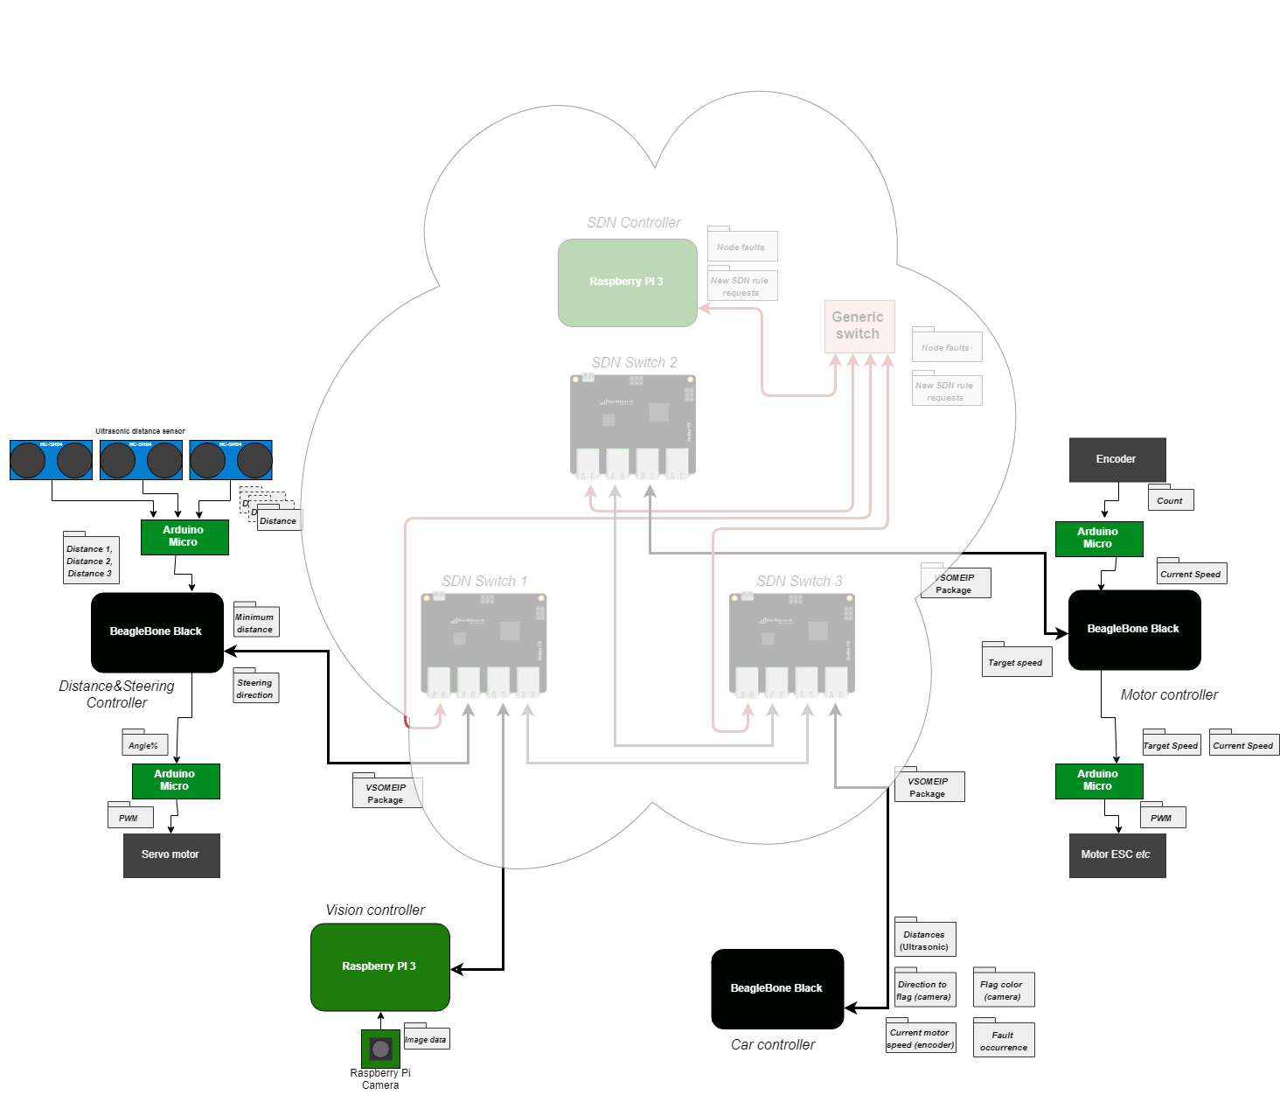
presentation/poster/figures/network.png
