fhyy/MF2063-ESS-NW-CAR/presentation/pp/figures/car.jpg

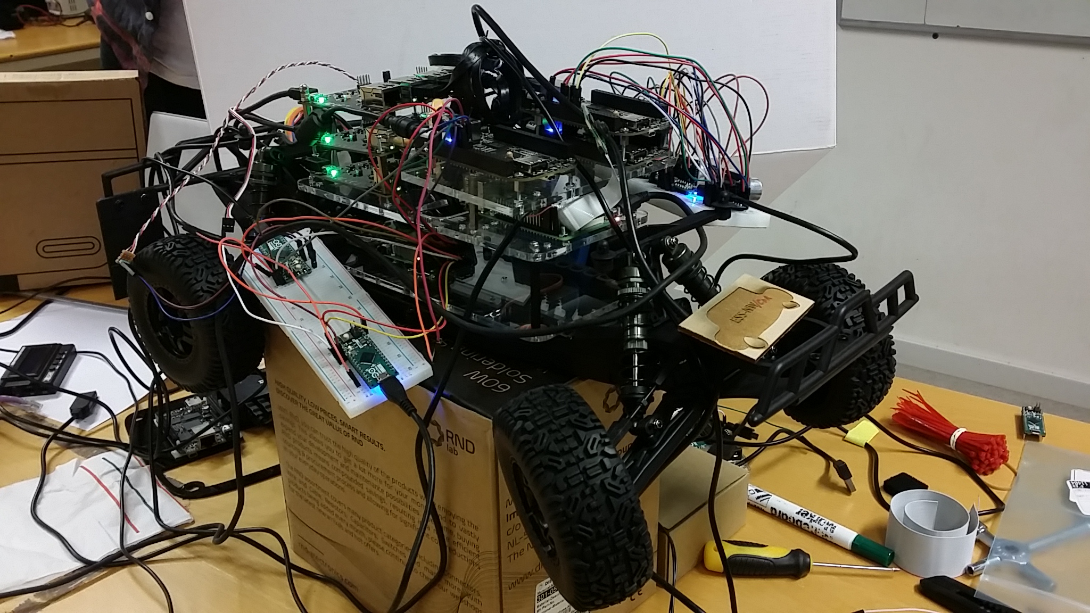
presentation/pp/figures/car.jpg
