fhyy/MF2063-ESS-NW-CAR/presentation/pp/figures/ir.jpg

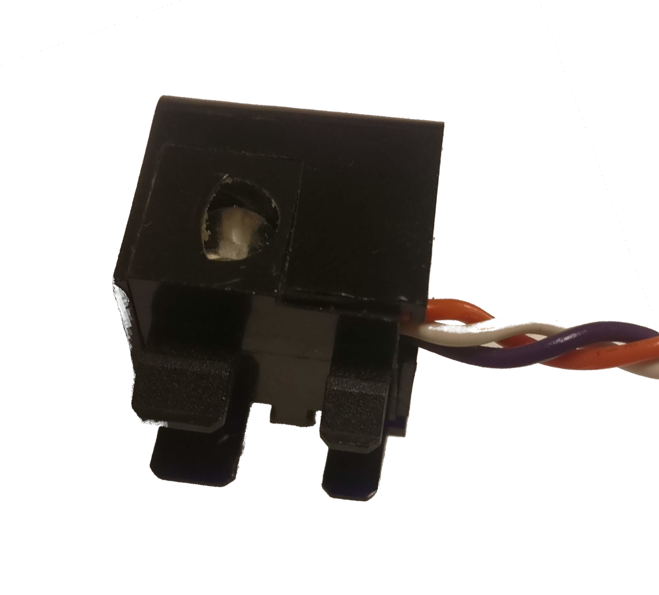
presentation/pp/figures/ir.jpg
