fhyy/MF2063-ESS-NW-CAR/presentation/pp/figures/netstat.png

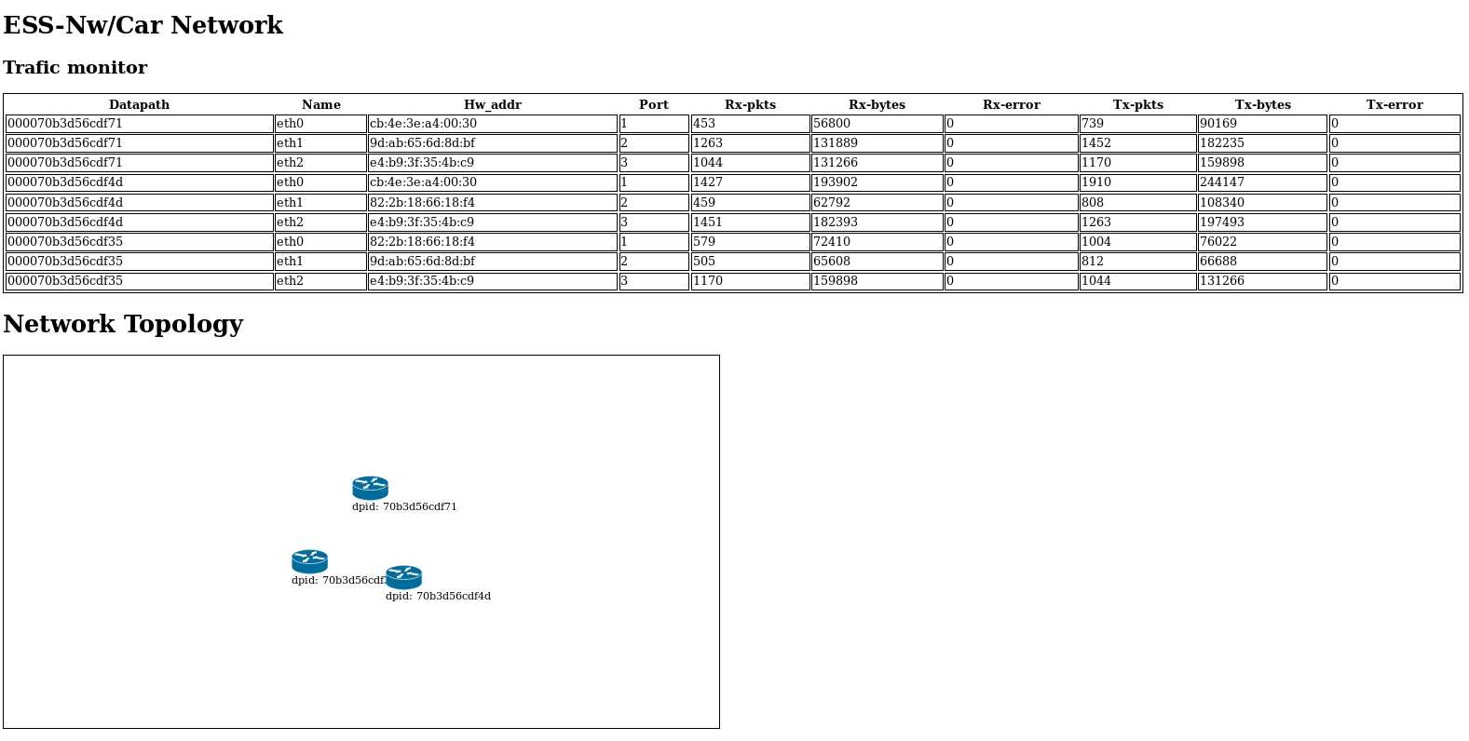
presentation/pp/figures/netstat.png
