fhyy/MF2063-ESS-NW-CAR/presentation/pp/figures/network.png

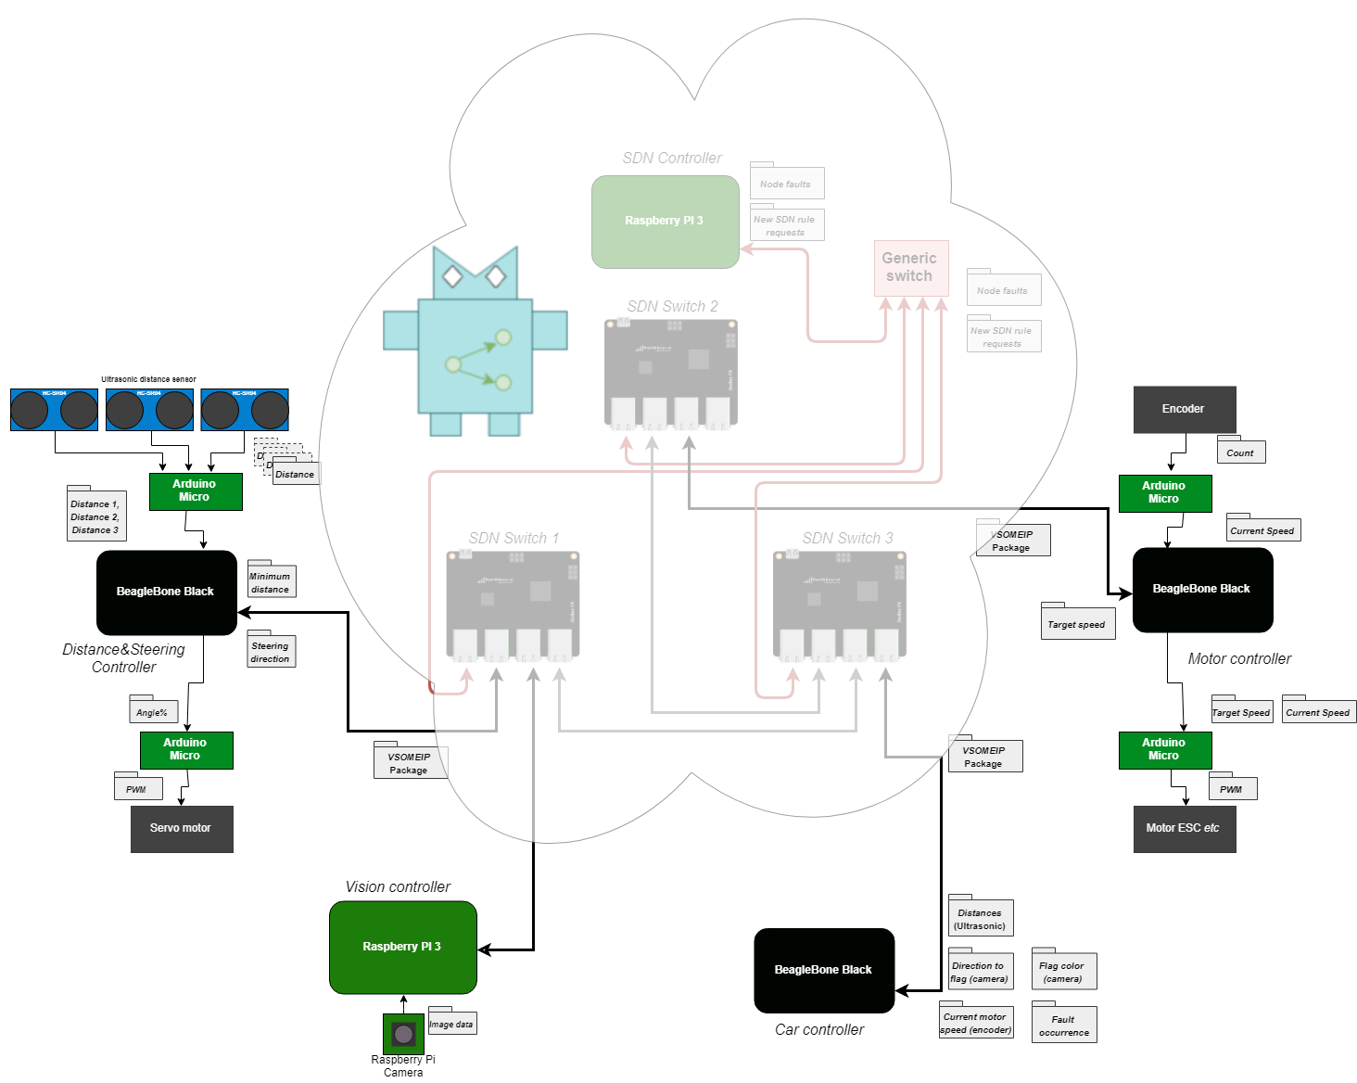
presentation/pp/figures/network.png
