fhyy/MF2063-ESS-NW-CAR/presentation/pp/figures/phys_car.jpg

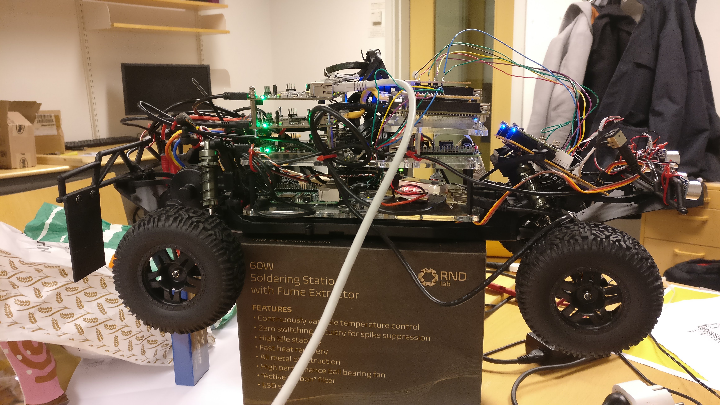
presentation/pp/figures/phys_car.jpg
