fhyy/MF2063-ESS-NW-CAR/presentation/pp/figures/sdn_info.png

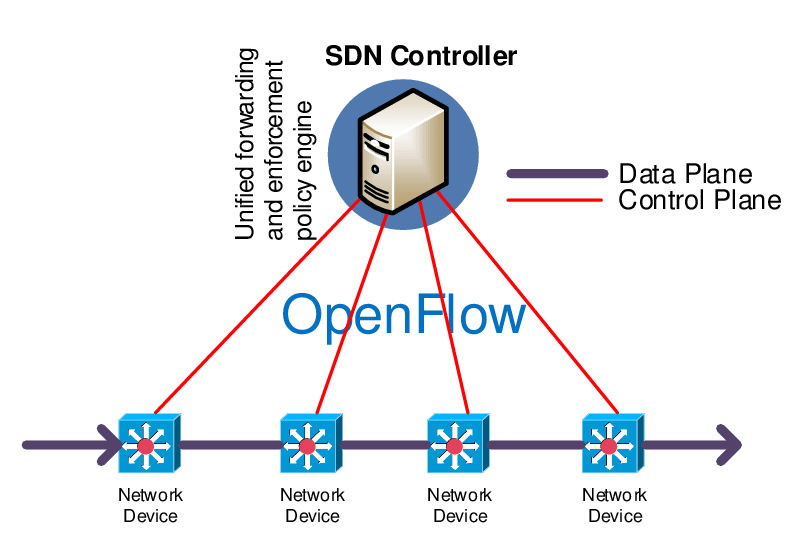
presentation/pp/figures/sdn_info.png
