fhyy/MF2063-ESS-NW-CAR/presentation/pp/figures/statemachine.png

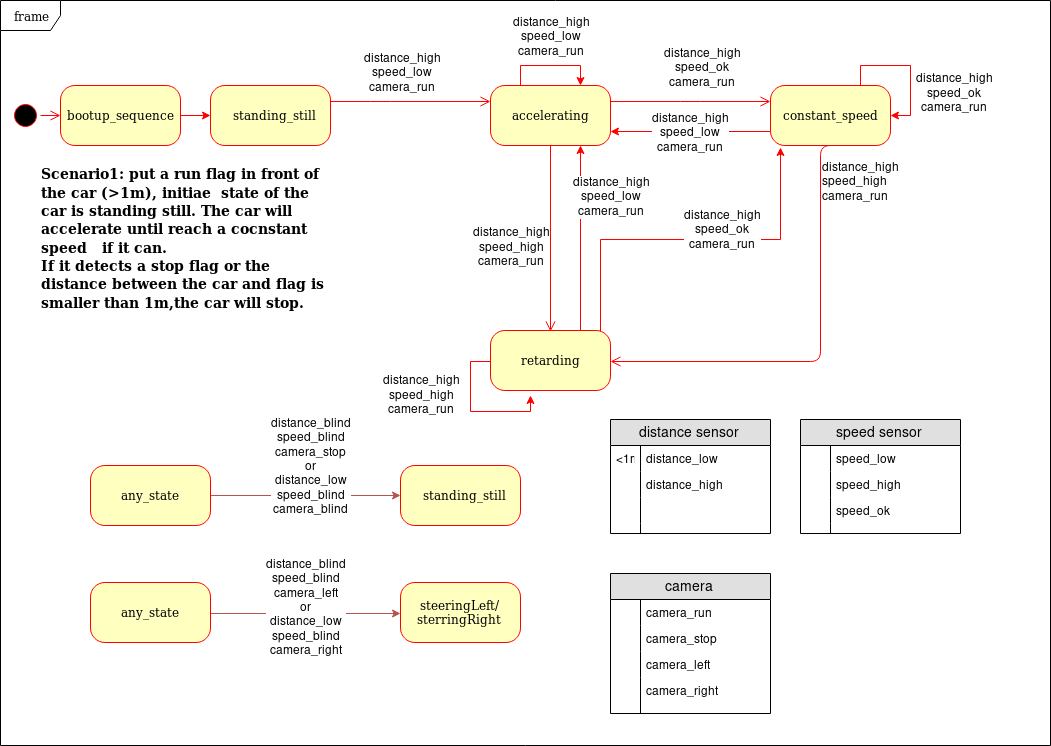
presentation/pp/figures/statemachine.png
