fhyy/MF2063-ESS-NW-CAR/presentation/pp/figures/vsomeip.png

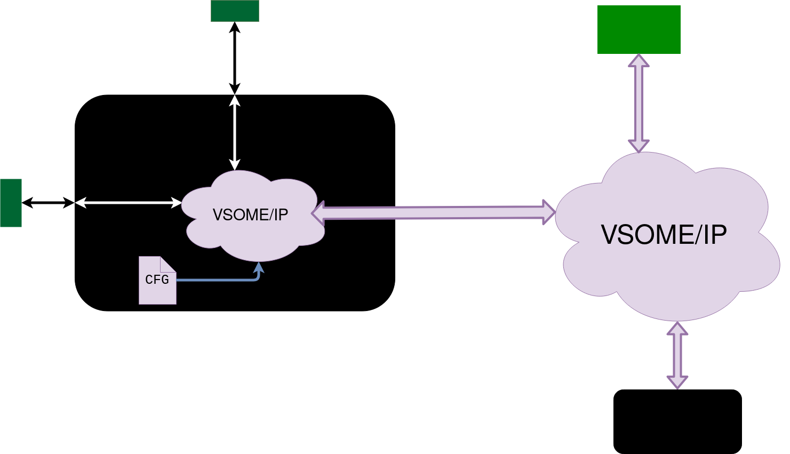
presentation/pp/figures/vsomeip.png
