fhyy/MF2063-ESS-NW-CAR/(list of files, cad)

Other CAD files:
platform/fusion-360/3d.f3z
platform/fusion-360/BeagleBoneBlack.f3d
platform/fusion-360/RPi.f3d
platform/fusion-360/ZodiacFX.f3d
platform/fusion-360/botenplata.f3d
platform/fusion-360/comp_pole.f3d
platform/fusion-360/fx_mount.f3d
platform/fusion-360/mount_pole.f3d
platform/fusion-360/switch.f3d
platform/fusion-360/switch_hoc.f3d
platform/fusion-360/topPlate.f3d
platform/fusion-360/top_bbb.f3d
