fhyy/MF2063-ESS-NW-CAR/Project_Management/Status_Report_4/evm.pdf

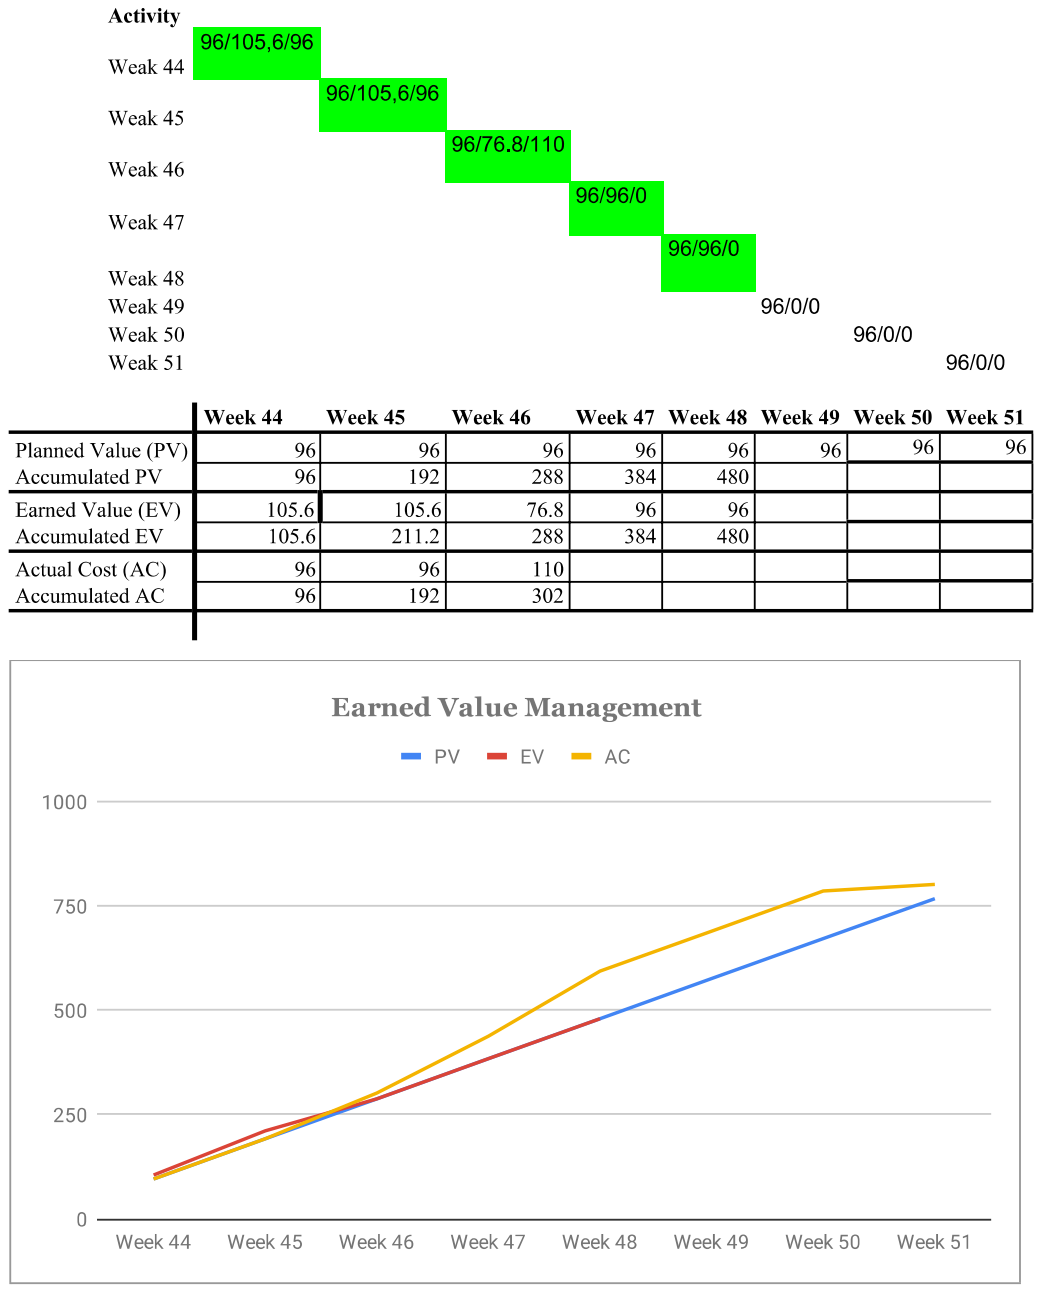
[picture p84: page 1]
