fhyy/MF2063-ESS-NW-CAR/Project_Management/Status_Report_4/resource_plan.pdf

Project name: | ESS-CAR/NW | Resource allocation plan

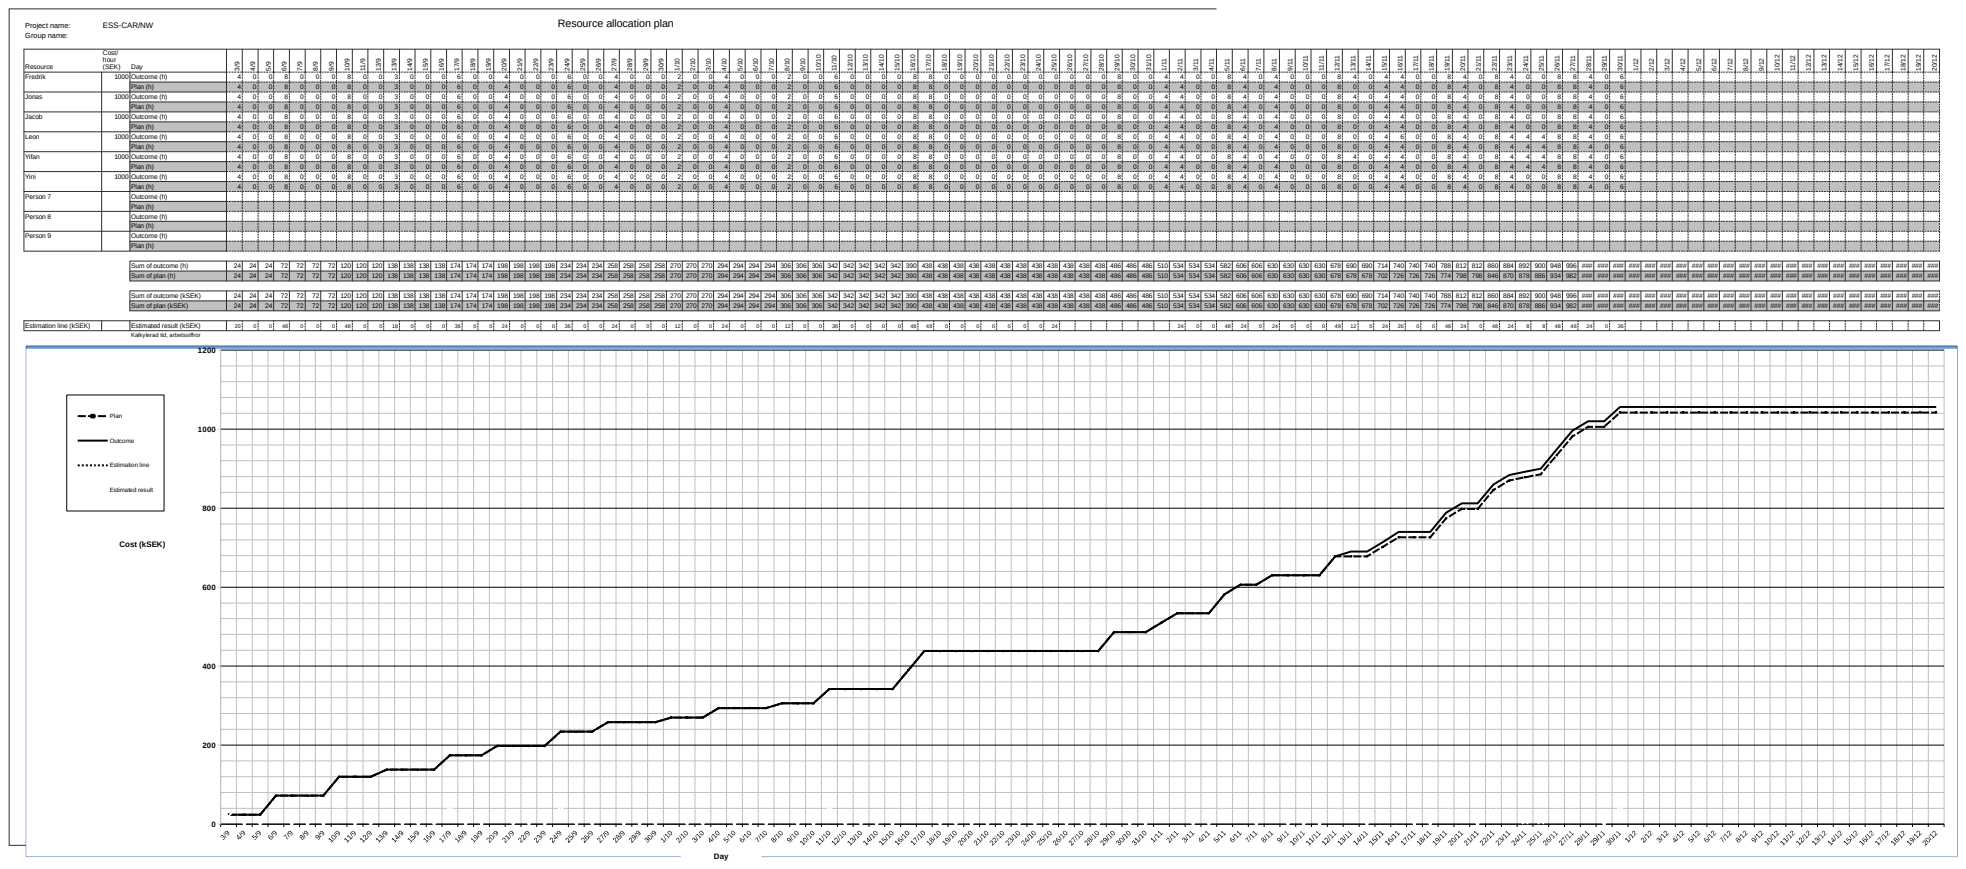
[picture p85: page 1]
Group name:; Resource; Day; Fredrik; 1000 Outcome (h); Plan (h); Jonas; Jacob; Leon; Yifan; Yini; Person 7; Outcome (h); Person 8; Person 9; Sum of outcome (h); Sum of plan (h); Sum of outcome (kSEK); Sum of plan (kSEK); Estimation line (kSEK); Estimated result (kSEK); Cost/ hour (SEK); Plan; Outcome; Estimation line; Estimated result; Cost (kSEK)

Kalkylerad tid, arbetssiffror
