fhyy/MF2063-ESS-NW-CAR/Project_Management/Final_Report_Management/figures/evm.pdf

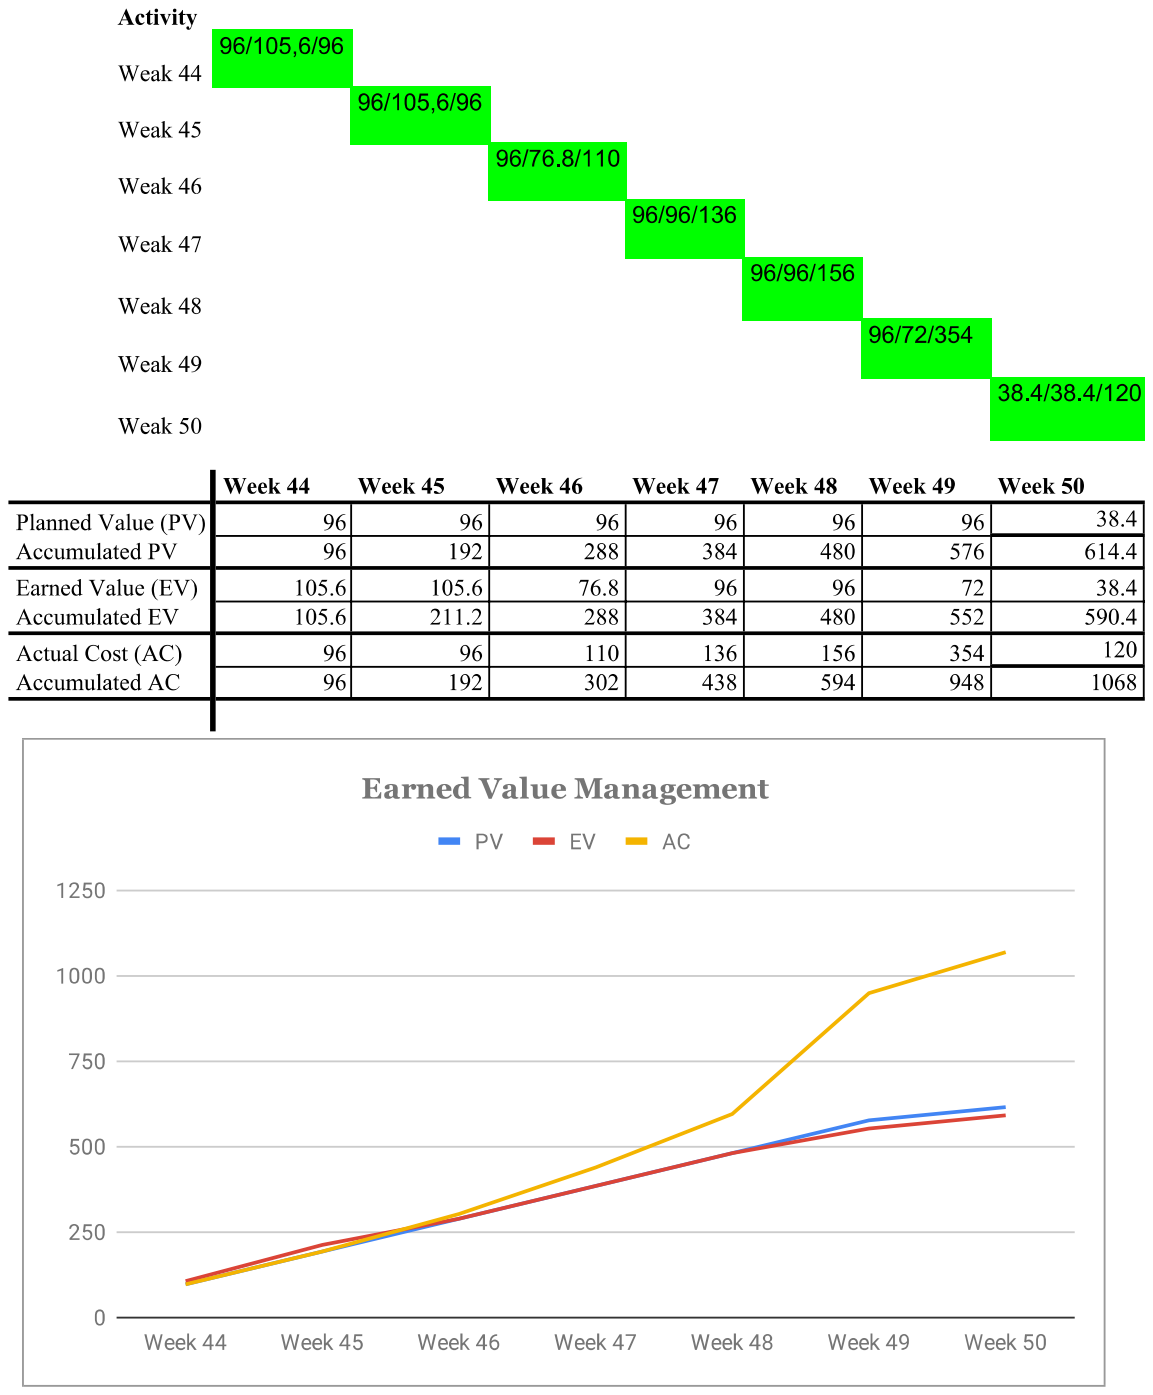
[picture p86: page 1]
