fhyy/MF2063-ESS-NW-CAR/Project_Management/Final_Report_Embedded/figures/boost_converter_curcuit.pdf

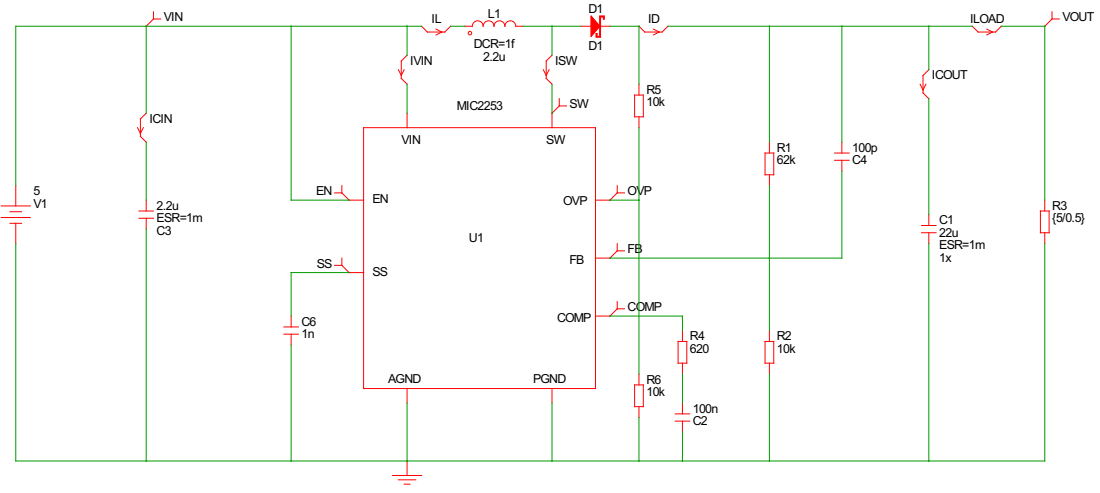
[picture p87: page 1]
