fhyy/MF2063-ESS-NW-CAR/pcb/pcb/Board_for_arduino_ir_esc/arduino_board.brd

## EAGLE design pcb/pcb/Board_for_arduino_ir_esc/arduino_board.brd (2018-12-12)

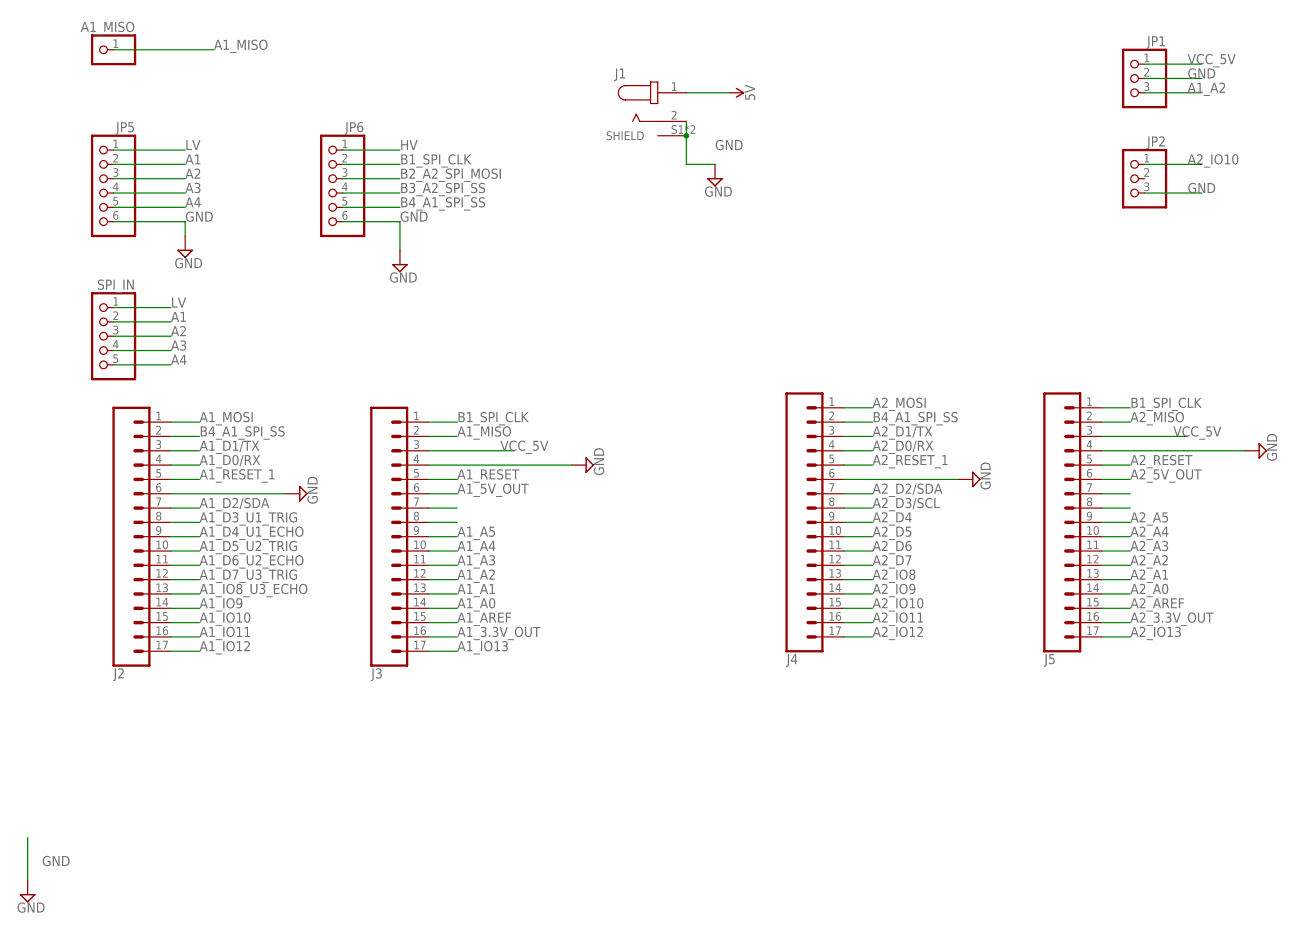
[picture p88: schematic arduino_board.sch]

Parts:
A1_MISO: PINHD-1X1; 1X01
J1: PJ-063AH; CUI_PJ-063AH
J2, J3, J4, J5: CONN_17; 1X17
JP1, JP2: PINHD-1X3; 1X03
JP5, JP6: PINHD-1X6; 1X06
SPI_IN: PINHD-1X5; 1X05

Connections:
5V: J1.1
A1: JP5.2, SPI_IN.2
A1_3.3V_OUT: J3.16
A1_5V_OUT: J3.6
A1_A0: J3.14
A1_A1: J3.13
A1_A2: J3.12, JP1.3
A1_A3: J3.11
A1_A4: J3.10
A1_A5: J3.9
A1_AREF: J3.15
A1_D0/RX: J2.4
A1_D1/TX: J2.3
A1_D2/SDA: J2.7
A1_D3_U1_TRIG: J2.8
A1_D4_U1_ECHO: J2.9
A1_D5_U2_TRIG: J2.10
A1_D6_U2_ECHO: J2.11
A1_D7_U3_TRIG: J2.12
A1_IO8_U3_ECHO: J2.13
A1_IO9: J2.14
A1_IO10: J2.15
A1_IO11: J2.16
A1_IO12: J2.17
A1_IO13: J3.17
A1_MISO: A1_MISO.1, J3.2
A1_MOSI: J2.1
A1_RESET: J3.5
A1_RESET_1: J2.5
A2: JP5.3, SPI_IN.3
A2_3.3V_OUT: J5.16
A2_5V_OUT: J5.6
A2_A0: J5.14
A2_A1: J5.13
A2_A2: J5.12
A2_A3: J5.11
A2_A4: J5.10
A2_A5: J5.9
A2_AREF: J5.15
A2_D0/RX: J4.4
A2_D1/TX: J4.3
A2_D2/SDA: J4.7
A2_D3/SCL: J4.8
A2_D4: J4.9
A2_D5: J4.10
A2_D6: J4.11
A2_D7: J4.12
A2_IO8: J4.13
A2_IO9: J4.14
A2_IO10: J4.15, JP2.1
A2_IO11: J4.16
A2_IO12: J4.17
A2_IO13: J5.17
A2_MISO: J5.2
A2_MOSI: J4.1
A2_RESET: J5.5
A2_RESET_1: J4.5
A3: JP5.4, SPI_IN.4
A4: JP5.5, SPI_IN.5
B1_SPI_CLK: J3.1, J5.1, JP6.2
B2_A2_SPI_MOSI: JP6.3
B3_A2_SPI_SS: JP6.4
B4_A1_SPI_SS: J2.2, J4.2, JP6.5
GND: J1.2, J1.S1 (SHIELD), J1.S2 (SHIELD), J2.6, J3.4, J4.6, J5.4, JP1.2, JP2.3, JP5.6, JP6.6
HV: JP6.1
LV: JP5.1, SPI_IN.1
VCC_5V: J3.3, J5.3, JP1.1

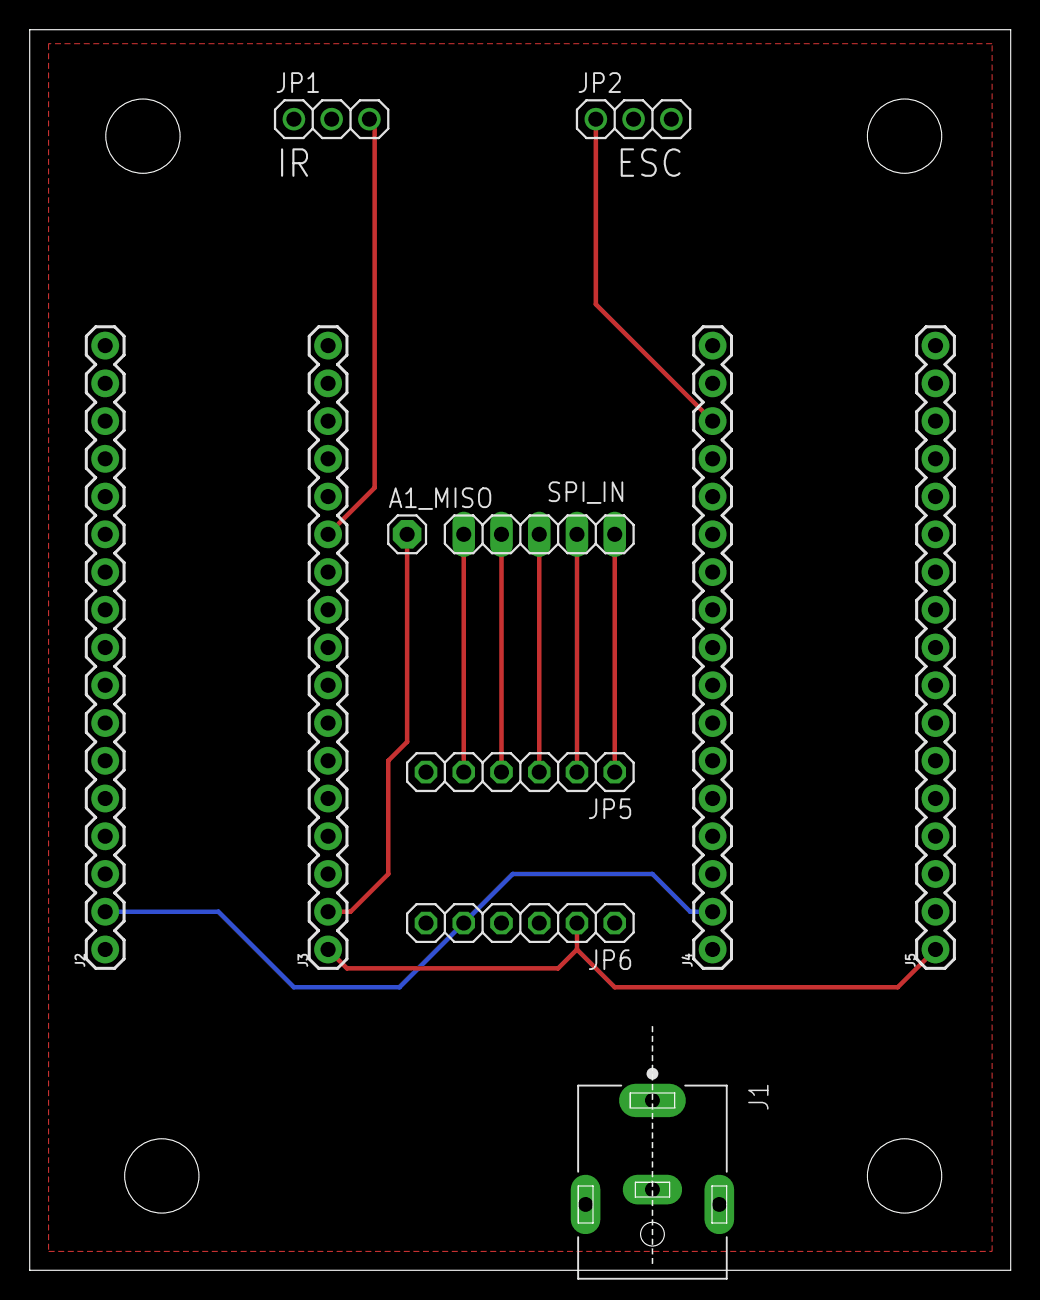
[picture p89: board arduino_board.brd from above]

Board: 2 copper layers, 66.0 x 83.5 mm, 11 parts (0 on the bottom side), 12 nets.
