fhyy/MF2063-ESS-NW-CAR/pcb/pcb/Ess_car_with_out_DC-DC/mainBoard.brd

## EAGLE design pcb/pcb/Ess_car_with_out_DC-DC/mainBoard.brd (2018-12-12)

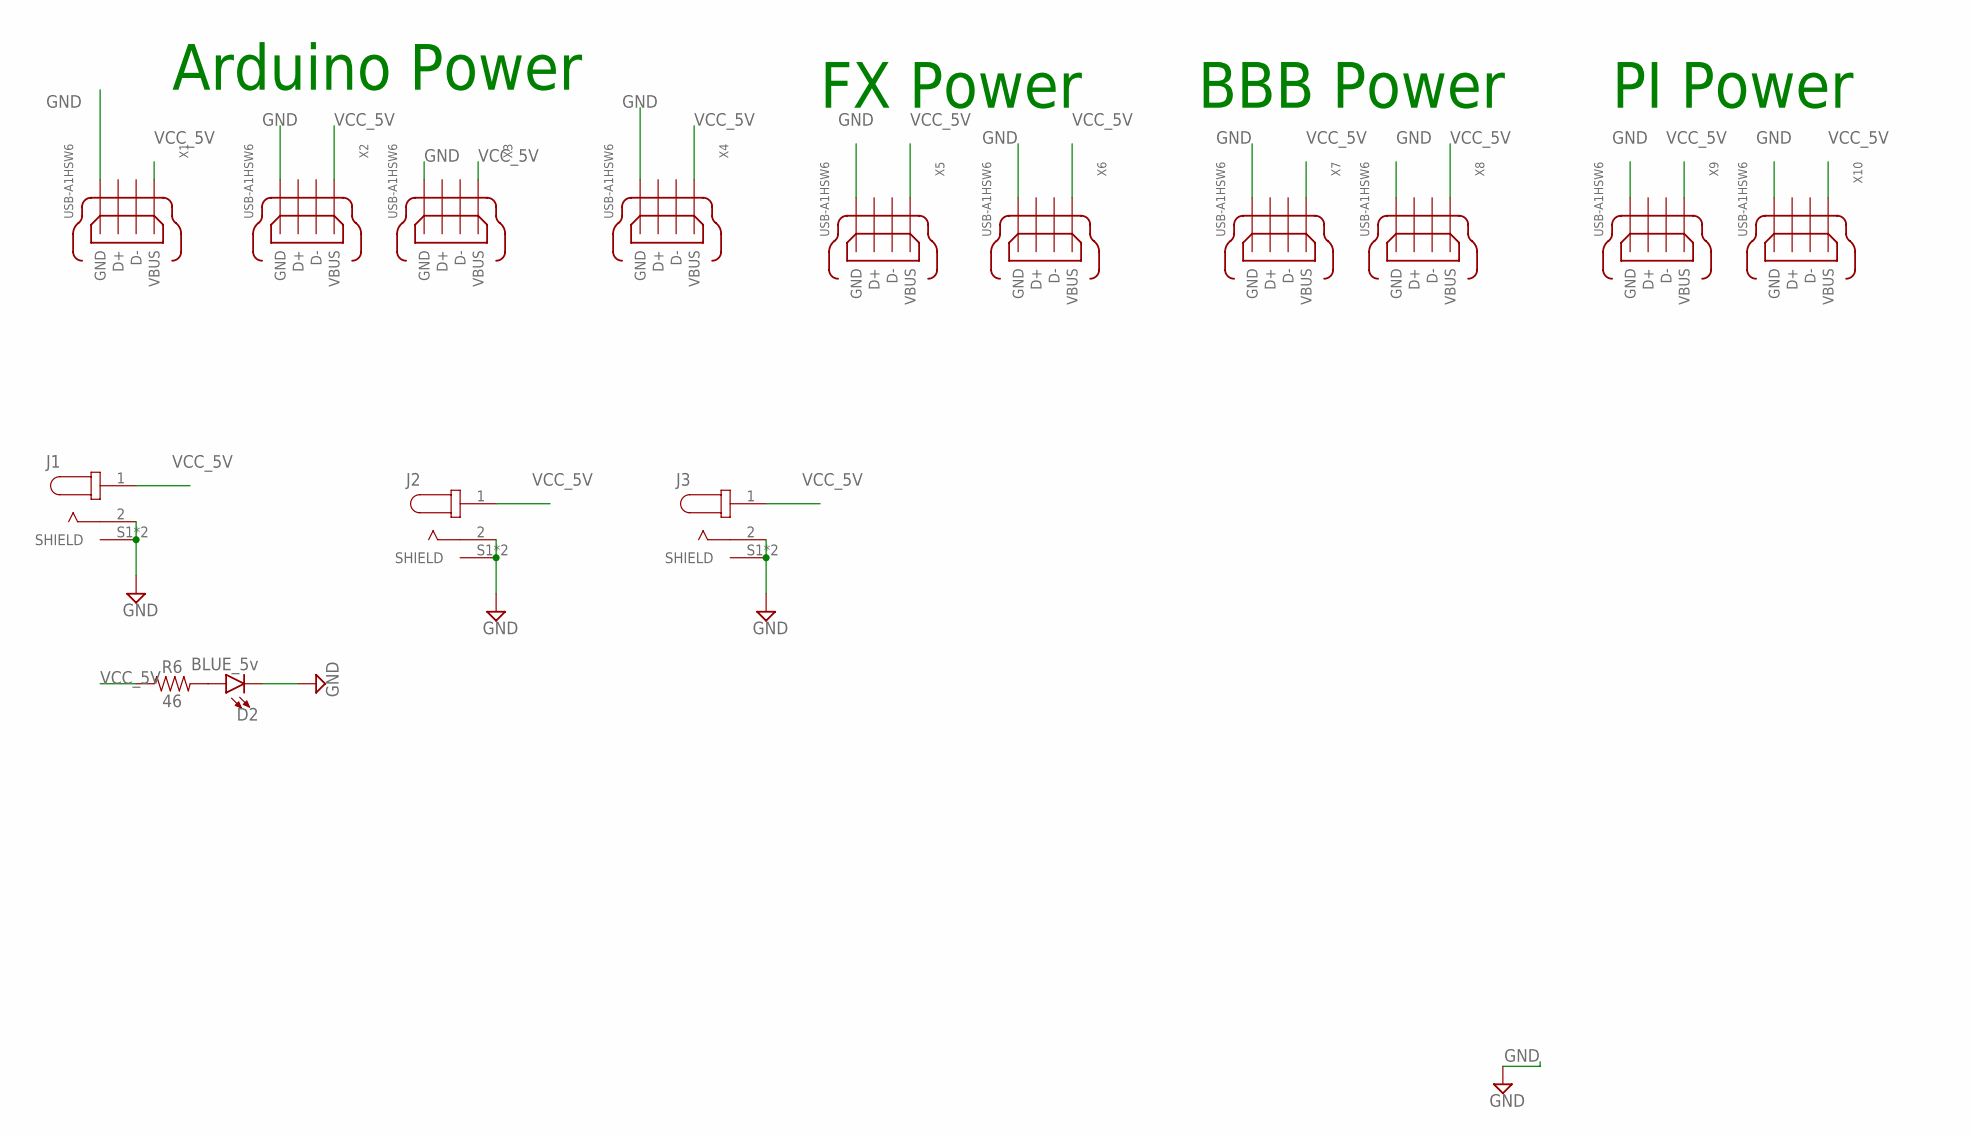
[picture p90: schematic mainBoard.sch]

Parts:
D2: BLUE_5v; LED-0603
J1, J2, J3: PJ-063AH; CUI_PJ-063AH
R6: 46; 0603
X1, X2, X3, X4, X5, X6, X7, X8, X9, X10: USB-A1HSW6; OST_USB-A1HSW6

Connections:
GND: D2.C, J1.2, J1.S1 (SHIELD), J1.S2 (SHIELD), J2.2, J2.S1 (SHIELD), J2.S2 (SHIELD), J3.2, J3.S1 (SHIELD), J3.S2 (SHIELD), X1.4 (GND), X2.4 (GND), X3.4 (GND), X4.4 (GND), X5.4 (GND), X6.4 (GND), X7.4 (GND), X8.4 (GND), X9.4 (GND), X10.4 (GND)
unnamed: D2.A, R6.2
VCC_5V: J1.1, J2.1, J3.1, R6.1, X1.1 (VBUS), X2.1 (VBUS), X3.1 (VBUS), X4.1 (VBUS), X5.1 (VBUS), X6.1 (VBUS), X7.1 (VBUS), X8.1 (VBUS), X9.1 (VBUS), X10.1 (VBUS)

Notes on the sheet:
Arduino Power
FX Power
BBB Power
PI Power

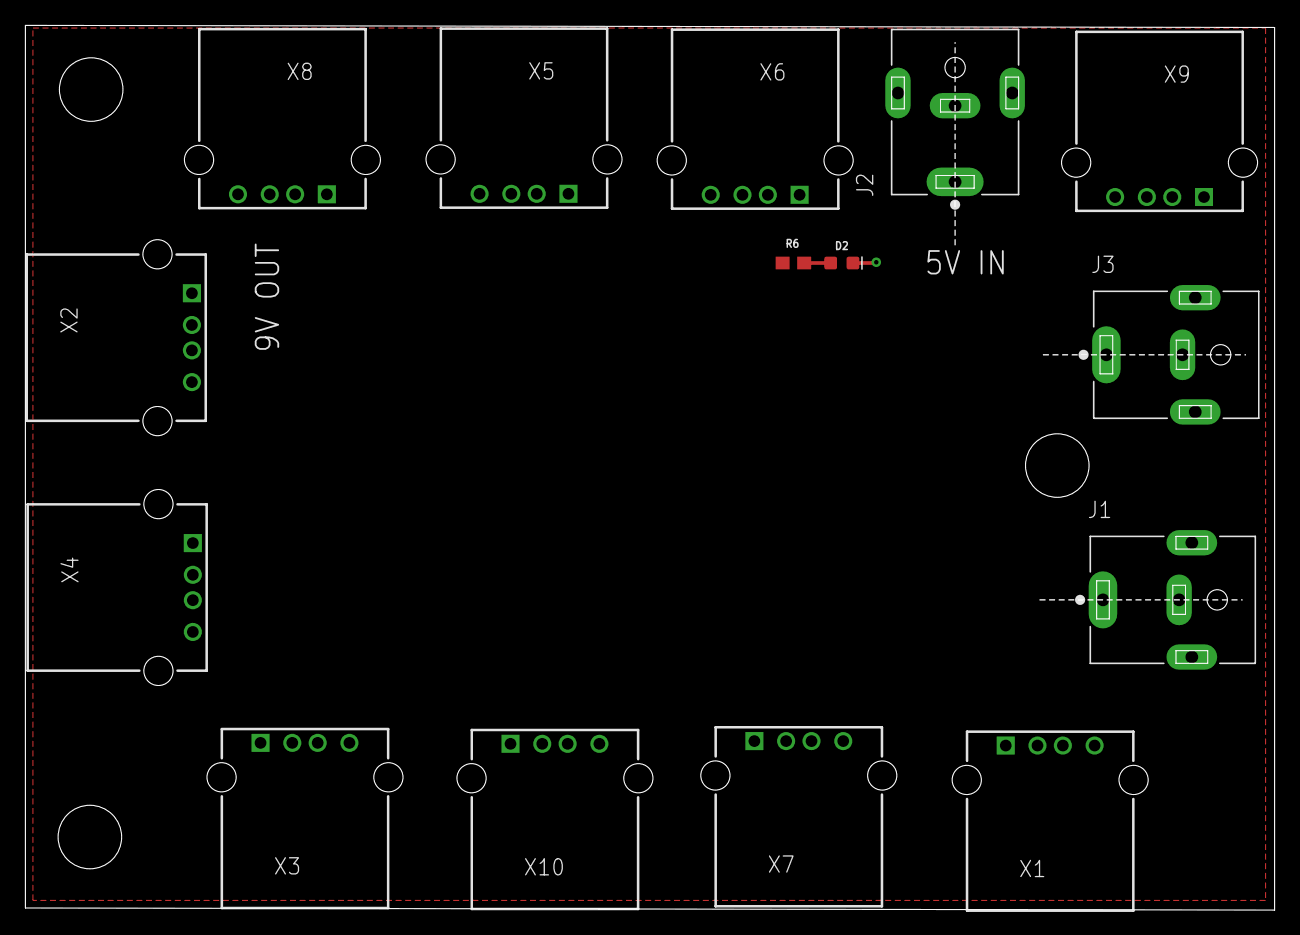
[picture p91: board pcb/pcb/Ess_car_with_out_DC-DC/mainBoard.brd from above]

Board: 2 copper layers, 98.4 x 69.7 mm, 15 parts (0 on the bottom side), 3 nets.
