fhyy/MF2063-ESS-NW-CAR/pcb/pcb/Ess_car/ultrasound.brd

## EAGLE design pcb/pcb/Ess_car/ultrasound.brd (2018-12-12)

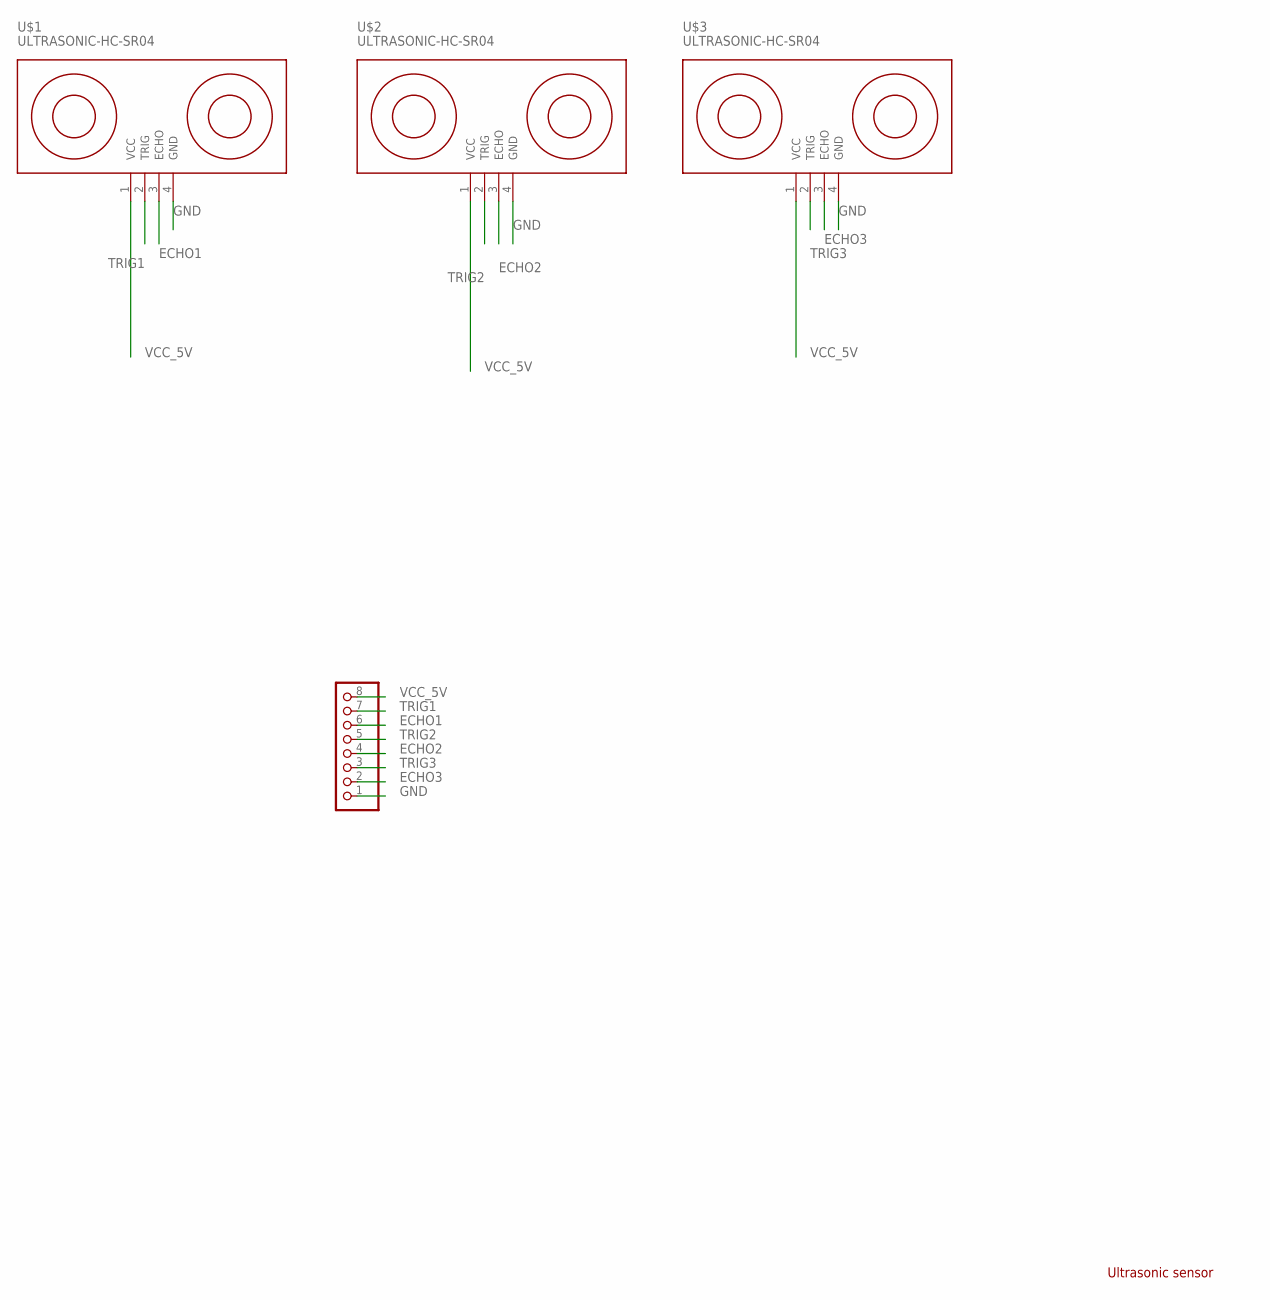
[picture p92: schematic ultrasound.sch]

Parts:
JP2: PINHD-1X8/90; 1X08/90
U$1, U$2, U$3: ULTRASONIC-HC-SR04

Connections:
ECHO1: JP2.6, U$1.3 (ECHO)
ECHO2: JP2.4, U$2.3 (ECHO)
ECHO3: JP2.2, U$3.3 (ECHO)
GND: JP2.1, U$1.4 (GND), U$2.4 (GND), U$3.4 (GND)
TRIG1: JP2.7, U$1.2 (TRIG)
TRIG2: JP2.5, U$2.2 (TRIG)
TRIG3: JP2.3, U$3.2 (TRIG)
VCC_5V: JP2.8, U$1.1 (VCC), U$2.1 (VCC), U$3.1 (VCC)

Notes on the sheet:
Ultrasonic sensor

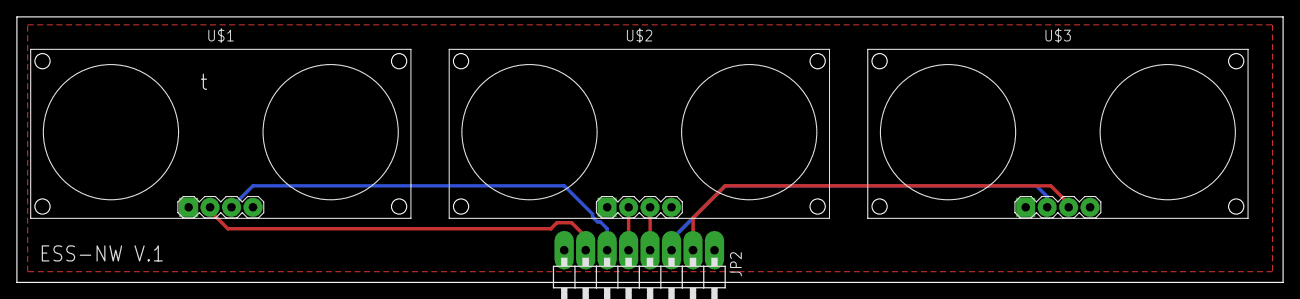
[picture p93: board ultrasound.brd from above]

Board: 2 copper layers, 149.8 x 31.4 mm, 4 parts (0 on the bottom side), 8 nets.
