fhyy/MF2063-ESS-NW-CAR/pcb/pcb/Ess_car/mainBoard.brd

## EAGLE design pcb/pcb/Ess_car/mainBoard.brd (2018-12-12)

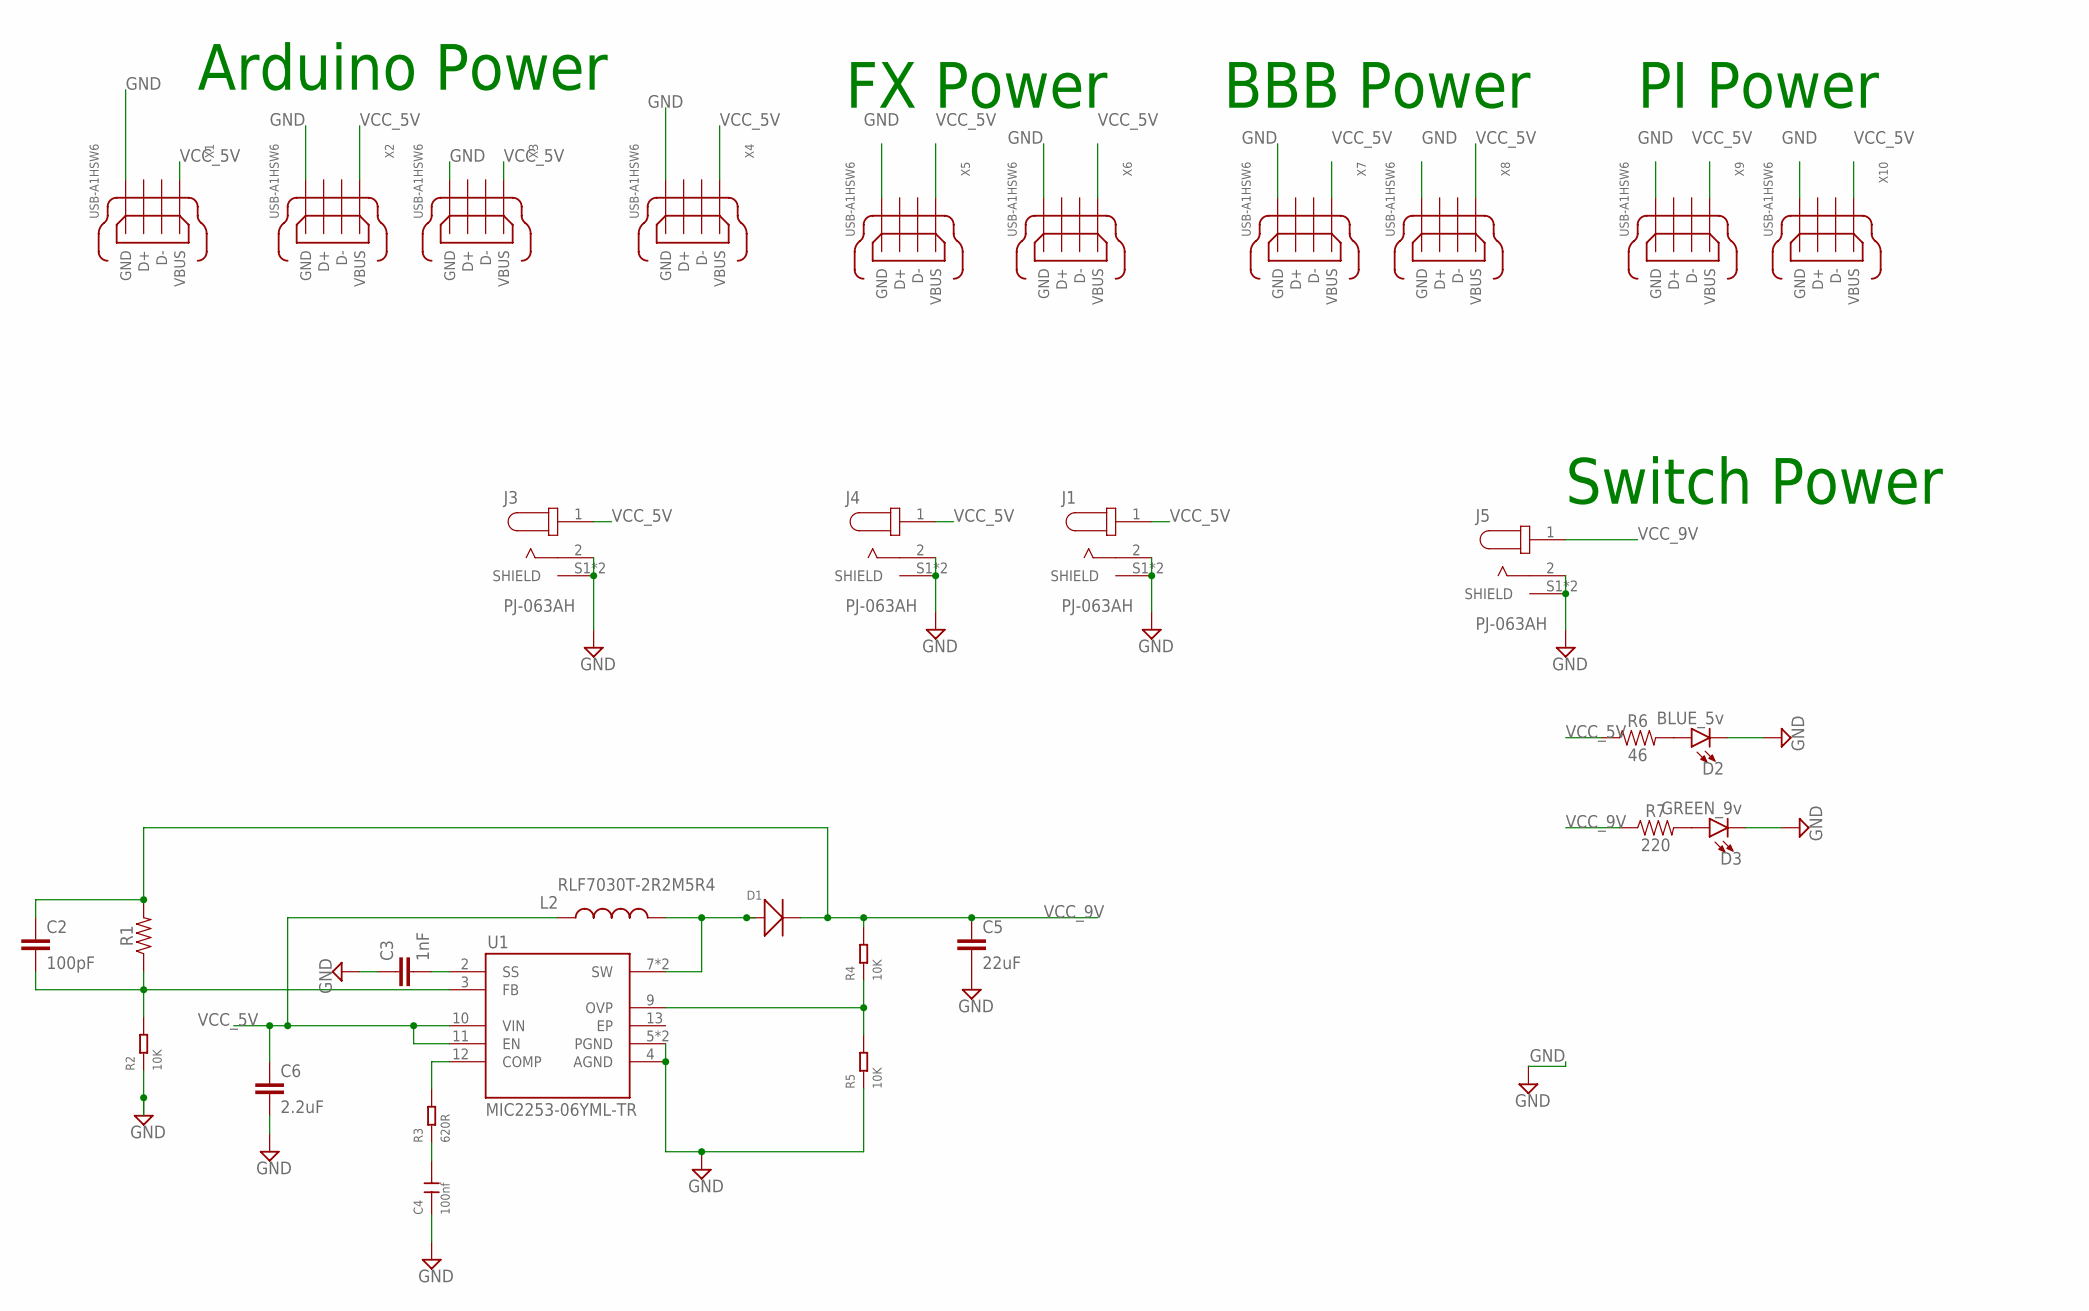
[picture p94: schematic mainBoard.sch]

Parts:
C2: 100pF; 0603
C3: 1nF; 0603
C4: 100nf; C0402
C5: 22uF; 0805
C6: 2.2uF; 0603
D1: SMD-DIODE-SCHOTTKY-28V-5A(DO-214AA); DO-214AA
D2: BLUE_5v; LED-0603
D3: GREEN_9v; LED-0603
J1, J3, J4, J5: PJ-063AH; CUI_PJ-063AH
L2: RLF7030T-2R2M5R4; INDP7368X320
R1: 62KOHM-0603-1/10W-5%; 0603
R2, R4, R5: 10K; R0603
R3: 620R; R0603
R6: 46; 0603
R7: 220; 0603
U1: MIC2253-06YML-TR; SON50P300X300X90-13N
X1, X2, X3, X4, X5, X6, X7, X8, X9, X10: USB-A1HSW6; OST_USB-A1HSW6

Connections:
GND: C3.1, C4.1, C5.2, C6.2, D2.C, D3.C, J1.2, J1.S1 (SHIELD), J1.S2 (SHIELD), J3.2, J3.S1 (SHIELD), J3.S2 (SHIELD), J4.2, J4.S1 (SHIELD), J4.S2 (SHIELD), J5.2, J5.S1 (SHIELD), J5.S2 (SHIELD), R2.1, R5.1, U1.4 (AGND), U1.5 (PGND), U1.6 (PGND), X1.4 (GND), X2.4 (GND), X3.4 (GND), X4.4 (GND), X5.4 (GND), X6.4 (GND), X7.4 (GND), X8.4 (GND), X9.4 (GND), X10.4 (GND)
unnamed: C3.2, U1.2 (SS)
unnamed: D2.A, R6.2
unnamed: R3.2, U1.12 (COMP)
unnamed: C4.2, R3.1
unnamed: C2.2, R1.1, R2.2, U1.3 (FB)
unnamed: R4.1, R5.2, U1.9 (OVP)
unnamed: D3.A, R7.2
unnamed: D1.+, L2.2, U1.7 (SW), U1.8 (SW)
VCC_5V: C6.1, J1.1, J3.1, J4.1, L2.1, R6.1, U1.10 (VIN), U1.11 (EN), X1.1 (VBUS), X2.1 (VBUS), X3.1 (VBUS), X4.1 (VBUS), X5.1 (VBUS), X6.1 (VBUS), X7.1 (VBUS), X8.1 (VBUS), X9.1 (VBUS), X10.1 (VBUS)
VCC_9V: C2.1, C5.1, D1.-, J5.1, R1.2, R4.2, R7.1

Notes on the sheet:
Arduino Power
FX Power
BBB Power
PI Power
Switch Power

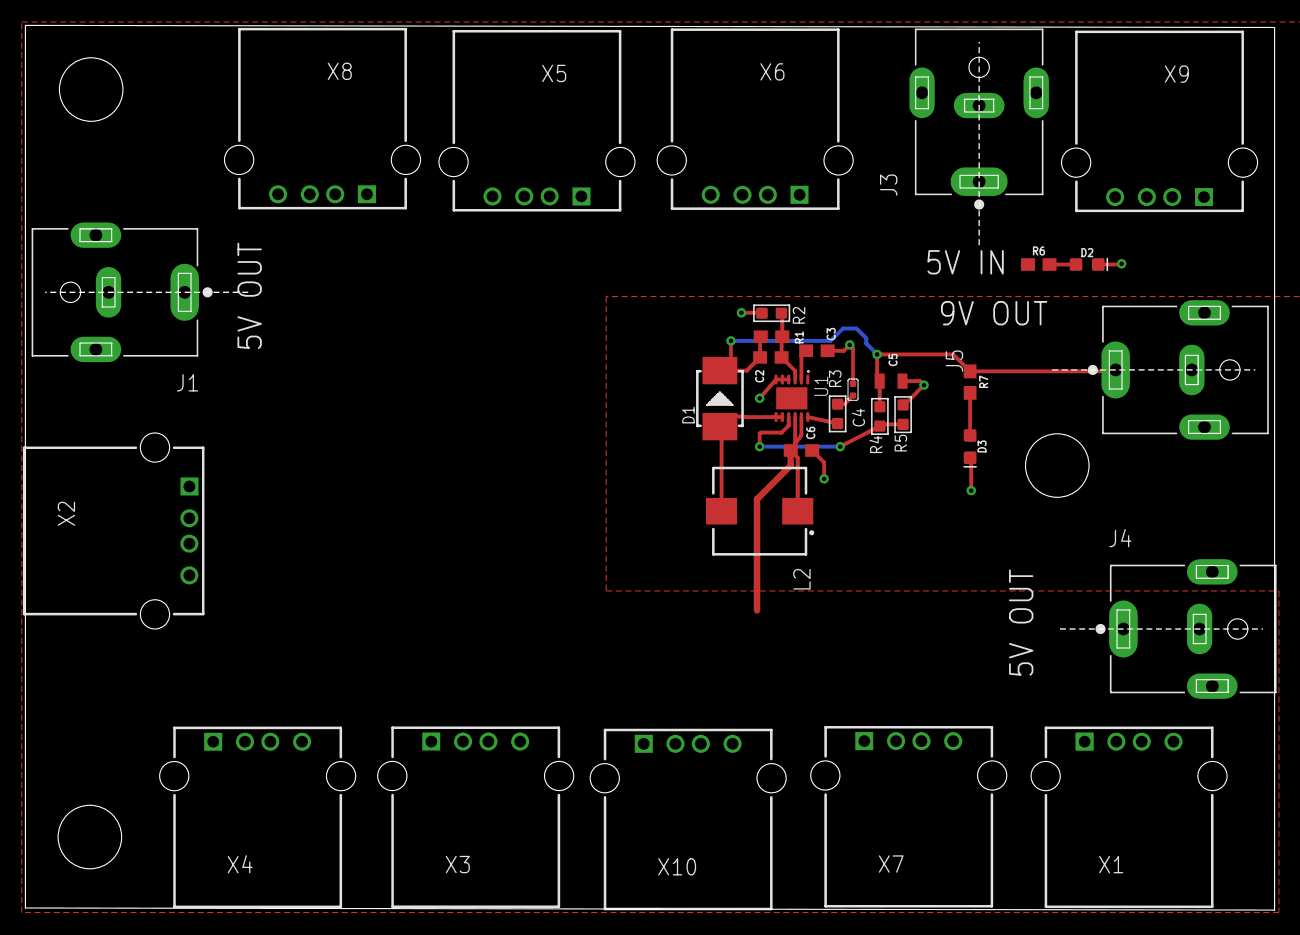
[picture p95: board pcb/pcb/Ess_car/mainBoard.brd from above]

Board: 2 copper layers, 98.4 x 69.7 mm, 31 parts (0 on the bottom side), 11 nets.
