fhyy/MF2063-ESS-NW-CAR/(commit log)

2018-09-24 Fetch and print value read by IR-sensor
2018-09-25 Added Arduino Mega motor control code
    This controller can be adjusted to for the Arduino Micro.
    It outputs a PWM signal @ 50kHz on pin 12 with varying duty cycle (0% ->
    100% -> 0% in 20 seconds).
    To fit the Arduino Micro one has to change the setupMotorPWM function so
    that it writes to the correct registers and settings.
    [motor_control.ino]
2018-09-30 A2BBB direction, arduino code need improvement
2018-10-01 arduino code fixed
2018-10-01 Revert "Fetch and print value read by IR-sensor"
    This reverts commit a516ba690af490fe243de0488b1718803d26fe40.
    [ard-speed.ino]
2018-10-01 Updated code and documentation for use with Arduino Micro instead
2018-10-01 Added code for steering, no data input yet but works with servo motor
2018-10-11 Change board to arduino micro
2018-10-18 bbb and arduino code for distance sensors updated
2018-10-30 Fix erroneous speed measurements
    [ard-speed.ino]
2018-10-31 Moved motor code and clean up. Awaiting SPI specification for setting PWM
2018-10-31 Transfer information over SPI
2018-10-31 Tuning of the steering and preparation for SPI
2018-10-31 Updated pin mapping in readme
2018-11-01 Configure arduino as an SPI slave
2018-11-02 Updated motor code and documentation
2018-11-04 working boost up converter 5v->9v
2018-11-07 bugs fixed, pass basic test case
2018-11-08 Added SPI communication and PID controller to node
2018-11-12 Added SPI communication code
2018-11-12 Fixed SPI communication, tested and done
    [servo_control.ino]
2018-11-12 available distance arduino version1, issues remained
2018-11-12 available bbb code for communicationg with two slave arduinos through spi
2018-11-13 Added diagram of the distance-steering node pin mapping
2018-11-15 Updated distance-steering diagram, added motor-speed diagram
2018-11-16 Periodic request threads
2018-11-16 Working skeleton threads
2018-11-20 Removed threads, started implementing library
2018-11-21 Fixed error in #include
    [dist_steer_service.cpp]
2018-11-22 Create process to handle SPI communication
2018-11-22 Add script to set up BBB for SPI communication
2018-11-23 No notification if no sensor data was read
2018-11-24 Shared memory w/ distance sensor, UNTESTED
2018-11-24 Added IDs for camera node
2018-11-24 Added camera and setmin functionality
2018-11-26 Minor bugfixes, commented out part of update_go_status()
    [car_ctrl_client.cpp, car_ctrl_client.hpp]
2018-11-26 Added skip-go flag for debugging, fixed ID error
    [dist_steer_service.cpp, dist_steer_service.hpp]
2018-11-26 fixed error with types in run_di()
    [dist_steer_service.cpp]
2018-11-27 distance.cpp replaced with dummy generator, ipc working
    [dist_steer_service.cpp, dist_steer_service.hpp, distance.cpp]
2018-11-27 Minor bugfix for debug printout
    [motor_speed_service.cpp]
2018-11-27 Speed+distance sensors and steer request working over vsomeip
2018-11-29 Misspelled folder name corrected (contoller => controller)
    [car_ctrl_client.cpp, car_ctrl_client.hpp, dist_steer_service.cpp, motor_speed_service.cpp]
2018-11-29 Add missing case to model
2018-11-29 Library restructure, simple test suite in prototype_test.cpp
2018-11-29 Changed SPI specification for receiving 2 bytes without risk of sync errors
    [motor_control.ino]
2018-11-29 arduino_di pin configure correctness
2018-11-29 complement for bbb2Ard code for two bbb boards
2018-12-01 Steer/Dist systems working over network
2018-12-01 Fix spi working every other execution
2018-12-01 remove wrong folder, add some doxygen-style comments in .hpp
    [car_ctrl_client.cpp, car_ctrl_client.hpp, main.cpp]
2018-12-01 Fix spi to work every execution
2018-12-01 Cleanup spi init script
2018-12-01 Move spi init script
2018-12-01 Copy spi init script to other node
2018-12-01 Spi works every time for dist-steer
2018-12-01 ESSPrototype now reads dist sensors correctly, no auto shutdown on embreak
    [car_ctrl_client.cpp]
2018-12-01 untested camera implementation
2018-12-01 Update spi script for debian 9
2018-12-03 use Flag class in get camera events
2018-12-03 change macro steering angle number definitions
2018-12-03 minor debug print changes, CMake now copies pyscript to build
2018-12-03 Added some sleep on the end of the thread loop
2018-12-05 blind camera and goStatus in statemachine temporarily, used for test
2018-12-05 fix statemachine stuck in standstill state problem
    [main.cpp]
2018-12-05 minor printout changes
2018-12-05 Added instructions on how to set up ESC and modified motor code to the new ESC configuration
2018-12-05 Writing motor req to shm should now work as intended, UNTESTED
2018-12-06 new frames for sdn and assembely
2018-12-06 Camera working but slow
2018-12-07 save before switch to poster
2018-12-07 update current speed in motor arduino in each iteration
2018-12-07 Added more test cases for sensor and actuator nodes
2018-12-08 add part of distance sensor implementation
2018-12-08 fix speed arduino, write half of curent speed to motor arduino
    [ard-speed.ino]
2018-12-08 send half of target speed to motor arduino
2018-12-08 Remove hardware SPI-init code from distance
2018-12-08 Remove hardware SPI-init code from speed
2018-12-08 distance sensor text done, figure need to be added
2018-12-08 add camera part
2018-12-08 Updated motor controller, and added comments for how to adjust the functionality
2018-12-09 SPI implementation text draft
2018-12-09 add literature spi subsection draft
2018-12-09 add float package, update spi connection figure
2018-12-09 Aesthetic change to shell, minor checkDistance bugfix on ccc
    [car_ctrl_client.cpp, ess_shell.cpp]
2018-12-09 Add SPI settings that dont survive
2018-12-09 correct distance sensor pin mapping in arduino code
2018-12-10 change motor-speed node sleep time to 200ms
2018-12-11 Update report with reflective object sensor
2018-12-11 Fixed one test case and deleted already tested cases
2018-12-11 pcb,power simulations
    [arduino_board.brd, arduino_board.sch, mainBoard.brd, mainBoard.sch, ultrasound.brd, ultrasound.sch]
2018-12-11 power schametic
2018-12-11 3d design for platfrom
    [3d.f3z, BeagleBoneBlack.f3d, RPi.f3d, ZodiacFX.f3d, botenplata.f3d, comp_pole.f3d, fx_mount.f3d, mount_pole.f3d]
2018-12-11 Removed additional servo writes
2018-12-11 Stops car when services are missing
    [motor_speed_service.cpp]
2018-12-11 Minor code style fix
    [dist_steer_service.cpp]
2018-12-11 Added part about ESC and Servo
2018-12-11 Minor compilation error fix
    [motor_speed_service.cpp]
2018-12-11 add some text in distance sensor
2018-12-12 SPI script description missing, other files described
2018-12-12 name fix
    [3d.f3z, BeagleBoneBlack.f3d, RPi.f3d, ZodiacFX.f3d, botenplata.f3d, comp_pole.f3d, fx_mount.f3d, mount_pole.f3d]
2018-12-13 Corrected declaration that had been messed up during commenting
    [car_ctrl_client.hpp]
2018-12-14 Update README.md with SPI information
